HenryLi-0/spark/firmware/README.md

# Firmware

Spark (for now and the foreseeable future) is using [Klipper](https://www.klipper3d.org/)!

NOTE: The current configuration (as of 3/31/2026) is UNTESTED! Be warned!

See [Klipper Config Reference](https://github.com/Klipper3d/klipper/blob/master/docs/Config_Reference.md) for more information.

Configs used:

- https://github.com/Klipper3d/klipper/blob/master/config/generic-bigtreetech-skr-v1.4.cfg
- https://github.com/Klipper3d/klipper/blob/master/config/example-corexy.cfg
