HenryLi-0/spark/CAD/README.md

# CAD

Check out the CAD, made in Onshape, [[here](https://cad.onshape.com/documents/2b9020a6dc26b5be6a34c293/w/4aea5c5de00aac87e58ab18a/e/e89b27766cadd97ed58f8716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)]! Or the huge `.STEP` file under the [over there](</CAD/spark-Full Assembly-2026-03-31 23-42-32.step>)!

*Note: **The 16mm M3 screws in the CAD are supposed to be 14mm M3 screws.** Unfortunately, Onshape's standard content does not include 14mm for some reason. Do NOT buy 16mm screws, there WILL be interferences in some areas. (If you already purchased 16mm, spacers should fix your issue, but no guarantees.)*
