HenryLi-0/spark/updatelogs/logs202607/07132026.md

# 7/13/2026 - 79th Update!

im still around you know lol

anyways, 9:06 PM, the day before flights to outpost! so, yeah, just finished packing, at least, most of it, gonna be quite a night, cant wait to wake up at... err... 3am or something (idk my sleep schedules fried)

ok brb

(did not brb)

anyways im in california now and the hackathon is startin soon (currently 5:38 PM in california), landing and travelling was good!

anyways, since it's like 8PM ish in NYC (i think?), that's it for now, good night!
