HenryLi-0/spark/updatelogs/logs202607/07092026.md

# 7/9/2026 - 76th Update!

yo and welcome back! it's 8:57 PM at night, don't have much time to waste now, today's hopefully printing day? (with the actual printer of course)

saw online last night from like a video from 6 years ago that using blue painters tape is a good idea (why does my s key consistently fall out now aaaaa), well look what i got here (figuratively), it's a roll of scotch blue 2090 tape!

ok, watched a couple of enlightening videos
- https://www.youtube.com/watch?v=meKYCQrZS54
- https://www.youtube.com/watch?v=TZiRAyaxzOE
- https://www.youtube.com/watch?v=gVU5If1VsAM

so, i think we're just gonna use some blue tape, seems pretty much good enough for our purpose, not sure if i really want to get orca slicer just now, i think i just want the printer to at least extrude something at this point in time?

center is roughly (50.00, 77.50, ~) right now, ok, wrote a little something to center the stuff, gonna be in the [`utils/`](</firmware/utils/>) section of the firmware folder, so (0, 0, 0) should hopefully be the center?

yeah, close enough! ok, it's probably a good time to apply the tape

ok, tape applied, cleaned the nozzle, planning on doing the paper thing right after, then we need to print like something flat real quick (if it works, since we still need to do the config stuff for the extruder)

quick 20 minute break to let it cool down later, it's 11:07 PM, time for the paper stuff!

so it doesnt really do a good job at staying level, but i do have a solution in mind, aka, having weights on both the sides to keep it flat. yeah. or my first idea of a rubber band thing stretching the entire length, but that's a bit less realistic. anyways, configs inputted! so at this point, the thing we need to focus on is getting the extruder config up and running!

ok, kinda/kinda not distracted and set up the slicer with the stuff, gear ratio is start (14) to mid (28->14) to final (28->12), where it ends

ok, after a quick sanity check, gonna do a test "print"! it's in quotes since it's actually not gonna have any filament, just gonna make sure the motion works/makes sense

ok, 12:31 AM, let's run it! ok, temperature below min or something (as in the gcode stuff), seems like the networks really spotty today...

12:40 AM and still figuring stuff out, hold on a second... ok, it's running! at least, the stuffs moving, not sure if it's printing well? idk, gonna watch it go! it's going! that looks... fairly realistic? idk why the heatbed's at 60.7C right now

ok, 12:54 AM, filament loaded on the top in a semi precarious matter, things are ready! 12:57 AM, here we go! timelapse running on my phone, let's see it! heat bed termperature good, extruder temperature rising, oh turns out i have to have the tab active for it to update the graph visually, whoops

well, reached the temperature, let's see something? oh it just stopped itself because axis werent homed, ok, test 2! 1:03 AM, z axis is lifting, here we go! hmm so the extruder didnt really try... anything. like it wasnt running the whole time (unless it's just a really small amount that the gearing cant handle?) quick timelapse (lookout) refresh

ok the issue might just be i didnt push the filament in enough, since i just gave it multiple aggresive tugs and a whole bunch just came out of the nozzle, 1:14 AM, here we go again! (i do not want to know what the weird vapors or gasses it just released (yes i saw it, which isnt a very good thing)) also, wow, the heating controls are tuned really nicely! ok, 1:17 AM, z axis going up again

so wasnt extruding anything, had to push on it to move, and that resulted in an obvious pile of sad sad

so i feel like this is a bit of a gearing thing, since small amount arent really wanting to come out

at least it got the rough shape correct? hmm i want to try it out without me pushing on the filament, expecting nothing to happen but who knows

yeah i think its just really under extruding, probably because of slip inside?

1:43 AM, trying again, yep, nothing good, it's now 2:00 AM, gonna go to sleep at this point

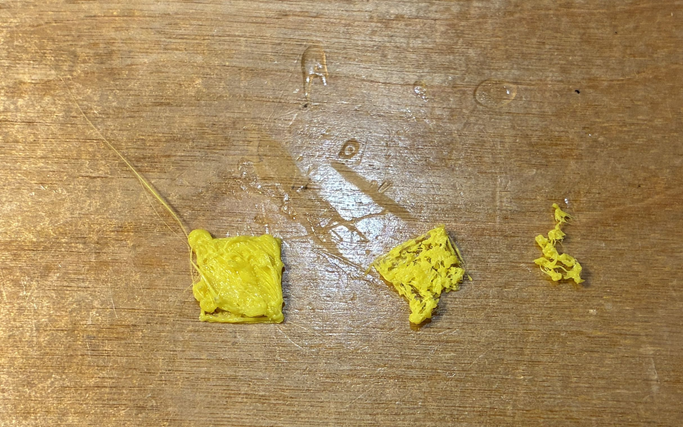
[picture p7: updatelogs/images/202607/07092026 - 1.png]
hmm


yeah. idk. the one on the left is forced filament, the middle had a bit of push at the beginning, the last one was mostly by itself. yeah, idk what to do at this point.

it's 2:03 AM, idk what to do, and yeah, we're kinda behind schedule. anyways, good night!
