HenryLi-0/spark/updatelogs/logs202607/07062026.md

# 7/6/2026 - 73rd Update!

well, today's a late start... anyways, 9:45 PM here in nyc, did some printing earlier but honestly not much, we do have two sets of tool heads to assemble, updated the extrusion gearing to be a bit tighter, idk

sent the smaller side gear to print since it keeps falling off

this thing really doesnt want to get printed

yo why does it keep failing

me when i cut a screw and both halves just evaporate

turns out upping the scaling factor was not a good idea (i increased it before the last few batches), so i guess we gotta turn that back down and suffer through manufacturing again lol

ok, 1:39 AM, being told to go to sleep right now, all other extruders assembled now!

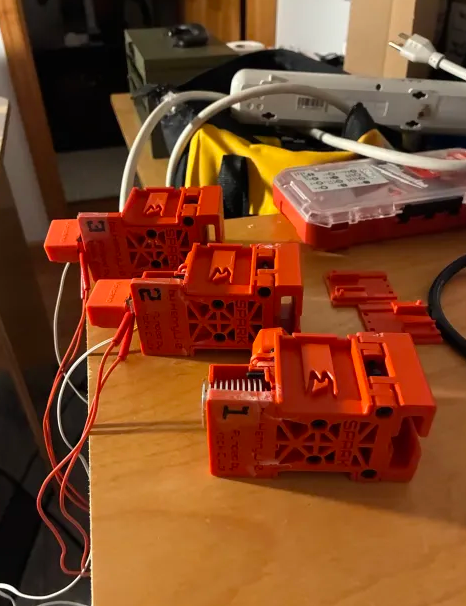
[picture p11: updatelogs/images/202607/07062026 - 1.png]
waw


ok, hopefully tomorrow's a bit more productive, that said, good night!
