HenryLi-0/spark/updatelogs/logs202607/07052026.md

# 7/5/2026 - 72nd Update!

ok, i had like the worst sleep last night, it's 4:06 PM (this sounds a little familiar...), we're back! yes, i somehow couldnt fall asleep after smiling at the printer and stayed up until 6:30-ish AM, then slept till 1PM, idk, my circadian rythmn and sleep schedule are beyond repair

anyways, work on printing today! we want to get printing! ive been considering looking into the bed mesh thing and i think its necessary for what it is because out plate isn't exactly the flatest (yes, i did try to bend it flat on the table best i can)

todo:
- part printing
    - latches
    - additional tools if time permits (not highest priority)
- **DONE** - electornics
    - **DONE** - add the switches or something, idk
- programming
    - **DONE** - set the configs
    - double check configs and all that stuff
    - **DONE** - start testing corexy movement
    - **DONE** - set z axis limits
    - reliability test
    - get extruder gearing to work
    - upload g code and go!

well, yeah, that's the stuff that needs work

can i create a bed mesh with a pulley i just glue to the print head

bathroom, brb

back at 4:40 PM, i should probably lock in 

anyways, how does one even connect this thing oh my S key just bent upwards in a way it never should oh it did it again uh oh

ok so we have to wire up the normally closed side for fail safe purposes (also why the endstops are inverted in the configs it seems)

ok, took like two hours but all that stuff is crimped and soldered, to test inputs time! ok, did the query endstops thing and it all shows up as good, 7:28 PM, off to dinner!

back at 8:49 PM, switches are taped down, didn't timelapse it unfortunately but took like 15 or 30 minutes or something, that's good, idk what to do about the z axis switch, i do want to get stuff printing before i shower though (really shouldve started printing at the start of today)

devestating loading times

well its been a second, stuffs printing now!

huh well i didnt even go shower yet since the rain started turning up and pouring a bit in, but yeah, that's done printing, i guess here comes another tool head?

today i learned you can export everything at once

a ton of bambu studio work later, things sent to print! ok, it's now 11:24 PM and like im feeling really unproductive today, let's get this homing working!

just to be clear, the axis of the printers should match the one in the cad (+x is towards the electronics side, +y is towards the LRS-150-24, +z is up), ok, let's get homing working (minus the z axis), and yeah!

THE DIRECTIONS ARE CORRECT NOW! YES YES YES

ok, the internet kinda went down, but currently working on the config and the min and max and endstop positions!

while the network's a bit down, let's work on the z axis limit! i guess we're just gonna secure it at this point for now? anyways, flipping the printer on it's side, yes it's still ok! we probably should mount the lrs-150-24 a bit better though...

well two parts just fell off the print bed...

ok, back, time to get zeroing the z axis!

the extruder doesnt really seem to want the filament... anyways

(55, 85, 119.5) is roughly the center of the build plate

oh i just realized that +z of the building area is actually -z in real life (since, the higher you go in the print, the lower the build plate needs to be)

ok, that's all fixed now, ok, so we are having a bit of zeroing issues where the corexy rods seem to skip the belt a bit, which isn't really good. ill probably make a print to force it to stay in contact, the belt's already pretty tensioned? ok looks like i have to tension it again but way harder

eh, kinda bored, i guess, oh the print's ready, anyways, as i was saying, 60c print bed test? almost heated the extruder whoops, i guess heating it to 100c is ok? just for a usage test

why the light flickering

ok, looks pretty good, gonna push the extruder to 230C

ok yeah, letting things cool down now, looks good so far!

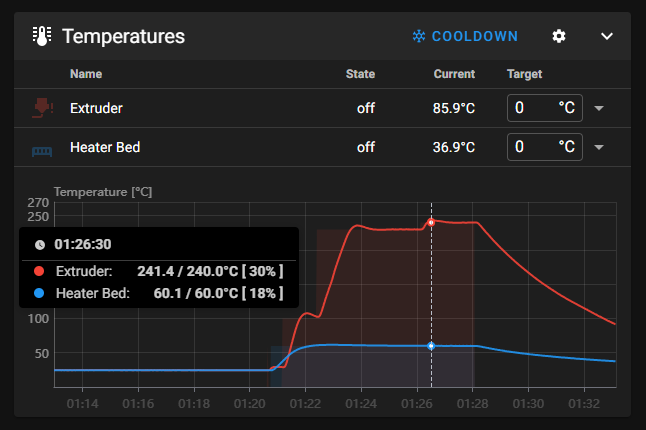
[picture p12: updatelogs/images/202607/07052026 - 1.png]
waw


ok, well, updated the todo list, time to go to bed now i guess

stuff's mostly cooled down by now, it has been like 21 minutes at this point? (from the start of heating things)

it did smell funny when it was really hot. huh.

well, that's it for now! gotta go attend something tomorrow morning and work starts the subsequent days. hopefully can set another tool to print before leaving? idk, well, that's it for tonight, it's 1:42 AM, good night!
