HenryLi-0/spark/updatelogs/logs202607/07042026.md

# 7/4/2026 - 71st Update!

ok, so it's 4:06 PM, a bit late of a starting time, today's theoretically programming day 1! realistically, we have a couple stuff to sort out (printing support plates and organizing the electronics), but yeah, construction is mostly done, i guess printing the other extruder plates and stuff should start soon?

anyways, here we go!

ok, some double sided tape used, gonna now cad a quick mount for the skr 1.4, probably just gonna double side tape it

ok designed and exporting!

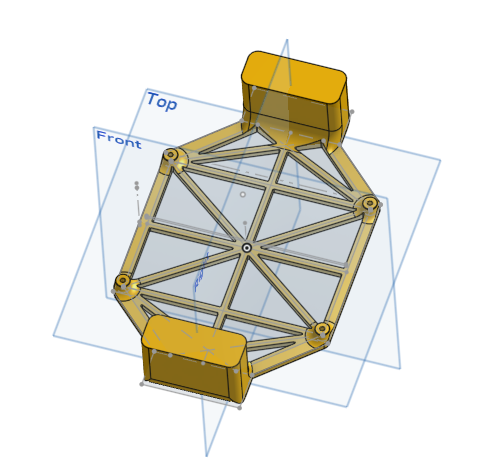
[picture p13: updatelogs/images/202607/07042026 - 1.png]


ok so this ones gonna take quite a bit to print. uh. yeah, idk what to do in that time, oh yeah, we need to screw in the blocks in the corexy for the ones inside the x sliders

hmm programming time, idk why my computer internet seems goofy

| 1 | 2 | 3 | 4 | 5 | 6 |
|A+ |   |B+ |A- |   |B- |
|BLK|   |GRN|BLU|   |RED|
| 1 |   | 2 | 3 |   | 4 |

board pin order is 2B, 2A, 1A, 1B

CURRENT BLK(A+) GRN(B+) BLUE(A-) RED(B-)
CORRECT GRN(B+) RED(B-) BLUE(A-) BLK(A+)

ok, motors moving! yes!

hmm switched the e1 and x a4988 boards

trying to figure out why x doesnt move as much as y

seems to be that port is just meh? or wire?

hmm smells like a config issue

spent like two hours trying to figure out why one motor was faster than the other, now both are slow and idk, i guess im just gonna leave it like that then?

ok, it's 12:23 AM, i dont think we can solder end stops mright now, but things working ok so far!

ok, got the fans wired up, a bit of cable management, it should span the entire area nicely (with some totally advanced zip tie technology), the extruder thermistor is also wired up!

2:16 AM and the heater's wired up! ngl, kinda scared, but hey, gotta test it at some point right?

first test is 30C (85F), ok, seems ok, 35C now (95F), ok, seems pretty nice and warm, gonna say its ok for now!

2:46 AM and idk why it sound like a whole server room or something, theres only like three fans running (including the one in the pi). anyways, wired up the extruder heater, kinda scared to test it (it's either gonna melt, or idk, i dont really wanna touch it). anyways, did a good amount of wire management, we still have to test if the z axis goes all the way up and if the wires are happy with that, and if the extruder wire works (then zeroing and actually printing sometime tomorrow, hopefully the extruder gears are good enough for that)

anyways, no time to waste, rather not write this joke anymore because i really dont want it to happen

wires seem alright, gonna preapre the config for the extruder

extruder ready, let's see it, ok, reached 35C! kinda overshoots but that's alright for now, iirc the heatbed takes a while to reach the target, so upped the p for the heatbed, decreased the p for the extruder, also decreased the z max velocity and max acceleration

ok, looks pretty good! not gonna try going for high temperatures on either one just yet, but we got something to work with now! probably gonna add the end stops, calculate the motion limits, and print a second extruder while that happens tomorrow!

yesterday didn't have a picture, so it's probably good to add one today right (also, we need to print a case for the inlet or something)

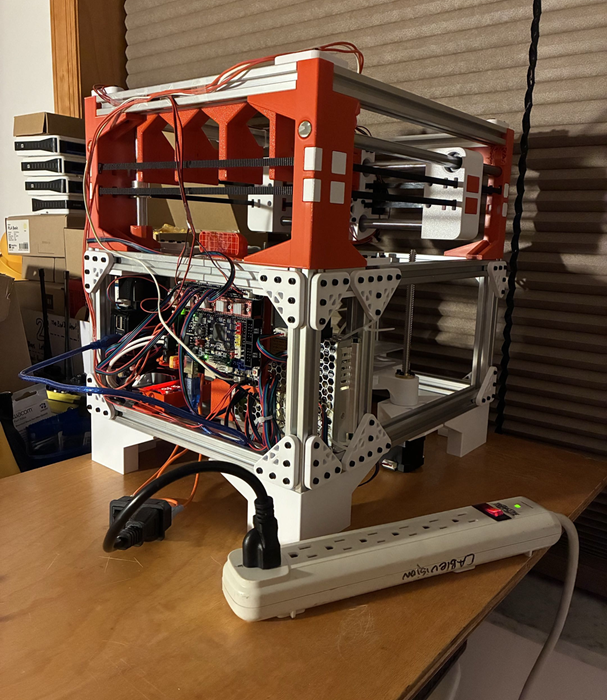
[picture p14: updatelogs/images/202607/07042026 - 2.png]


hmm we should probably update the todo list

todo:
- part printing
    - latches
    - additional tools if time permits (not highest priority)
    - **DONE** - skr 1.4 support plate or something
- electornics
    - **DONE** - live test 3 (inlet, PSU, LM2596, skr 1.4, and raspberry pi 4)
    - **DONE** - connect heating units and other things
        - **DONE** - quite obvious, but fans (x3), heatbed (x1), extruder thermistor (x1), extruder heater (x1)
    - add the switches or something, idk
    - **DONE** - clean up the electronics bay (it's probably cluttered at this point)
- programming
    - set the configs
    - double check configs and all that stuff
    - **DONE** - start testing heating stuff up
    - start testing corexy movement
    - set z axis limits
    - reliability test
    - upload g code and go!

well, good amount done today! mostly actual printing testing and stuff tomorrow!

got distracted for a second and now it's 4:02 AM, here's another picture i was gonna add!

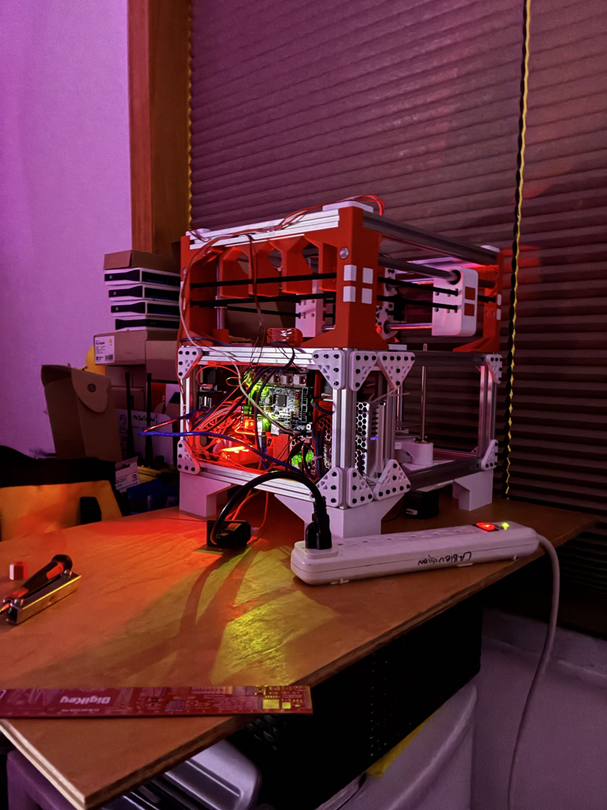
[picture p15: updatelogs/images/202607/07042026 - 3.png]


well, with that said, good night!
