HenryLi-0/spark/updatelogs/logs202607/07012026.md

# 7/1/2026 - 68th Update!

wdym it's a new month... anyways, time to lock back in! electronics work was going pretty decently, time to continue with that, printing gonna be a bit delayed today since the temperature in nyc is abysmal

also need to cut that usb c wire

electronics time, it's 3:37 PM right now, tool stuff getting printed later

half an hour later, cut the aliexpress usb power wire, split the wires, then attached the lm2596 (idk why i remember the numbers) and plugged the usb end (trimmed both sides of the cut) and then saw it worked alright, just a note to check the output voltage when attaching it to the lrs-150-24 (had to check that one) before actually plugging in the pi. anyways, gotta wire the bbt thing with actual power wires, then probably need to do a soldering job for the outlet (well technically isnt it called an inlet? idk)

why are these wires secured with food wrap

for a second i thought i forgot to add the inlet thing to the bom, then remembered its in the digikey bag oops (whys there an microsd to sd card converting case thing in the aliexpress box, whoops, mustve been from last night)

though we have 4m of wire (wait really?), it only wraps around the structure a little less than three times, just an important constraint

ok, so its been a pretty long while. in fact, i learned how to crimp in that time (woah), so that was cool. anyways, check this out!

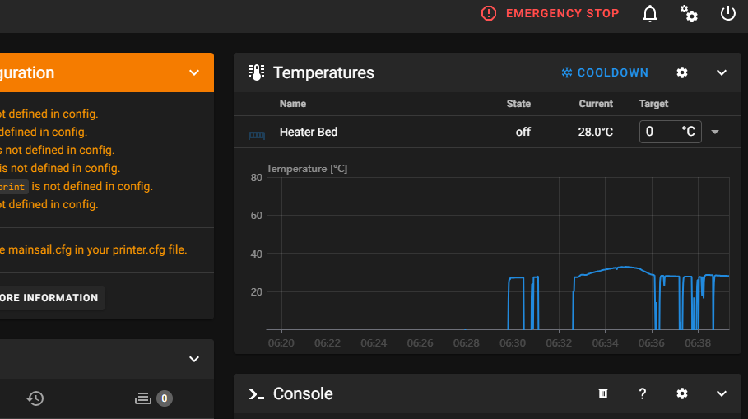
[picture p16: updatelogs/images/202607/07012026 - 1.png]
waw


yep, that's the thermistor on the build plate! it also works with the one on the extruder, so that's nice! anyways, i dont have any free jst connectors on hand, so i cant exactly make it line up, but dupont seems to be working just fine (yes, i know its crazy sketch, shh)! i do probably want to hot glue the connection though... also, ignoring the questionably lower temperatures lol

oh yeah, also did something goofy i forgot, oh right, i struggled connecting the larger 16 AWG wire into the LM2596, turns out the screw was actually a different head and it really looked like another one.

anyways, 7:09 PM, gonna set a tool to print (like, printing tons of tool parts, see ya in a sec)

spam export spam export spam export

ok, set to print, currently 7:20 PM, see ya in a bit, off to dinner, gonna head down to cut the t screws afterwards!

an eventful after-dinner later, the t screws are cut and the corexu has full motion range, and a 15x15 build plate has been created! didnt timelapse it unfortunately since the wifi connection was weirdly weaker than normal, but it was like 45 minutes or something. anyways, the result is an aluminum (?) plate which should be enough for our purposes. the screw holes i drew were a bit off, but it's really whatever, just hopefully it doesnt, you know, go flying off during a print or something.

anyways, the tool stuff is printed! nice! set two is going right now, but gonna test assembly

this is extruder gearing is so cursed. switched everything to use filament instead of, you know, printed rods, everything was just thrown out that couldnt be fixed (only like 7 parts were fine of all that), 

this isnt good, canceled movie night tonight, gonna try fixing all this

i think we're just not gonna use any live axles, just use filament as dead axles, which should let everything spin nicely and remove the need to print out a bunch of bearings/bushings

issues:

- **GOOD** - shaft collar does not have enough clearance
- **DONE** - all gearing axles need to be dead axles for filament now
- filament grabbing gears NEED to be done!
- **GOOD** - no bearings or bushings! please!
- **FINE** - wind tunnel thing just... uh. collapses, but that's fine for now
- design does not consider wiring! like, at all!

one crimping intermission later, i think we just need to stick a bunch of toothpicks to edge the dupont connector to work with the jst. yes, that's probably a sentence you never expected to hear, i know. anyways, electronics aside, WE HAVE CAD TO FIX! my idea is getting started earlier tomorrow, setting all the tool stuff to print, then working on the corexy belting and the rest of electronics while waiting (a solid two hours of printing should provide enough time?)

yeah so its been a while and got a bit side tracked

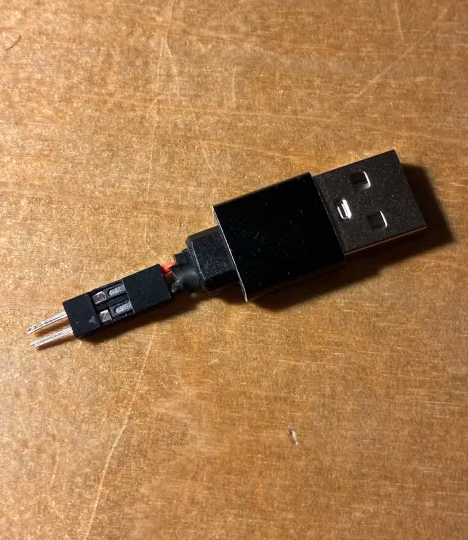
[picture p17: updatelogs/images/202607/07012026 - 2.png]
hmm


anyways, 1:57 AM now, gonna end it here, lots to clean up yikes, hopefully earlier start time tomorrow? anyways, that's it for now, good night!
