HenryLi-0/spark/updatelogs/logs202606/06302026.md

# 6/30/2026 - 67th Update!

funny number haha

anyways, actually started at like 8AM today, but starting to write logs at 3:46 PM right now, did quite a bit of work, finished printing the pulley areas of the corexy stuff, i guess its time for corexy assembly!

ok, 4:10 PM, let's actually start

so its 6:55 PM and we got a corexy layer now! there is a bit of wobble, but i hope the belts and stuff should be able to sovle that, some docking bay stuff is printing right now, the t screws are still too tall so we'll have to cut them a bit later, had to cut the corners of the upper sliding sides of the pulley areas since they had collisions (shouldve checked for this), but they've been removed (not spending 8+ hours printing new ones and using like 230g of filament), so yeah, got a bit of clean up to do over there

gonna reflash the sd card with raspberry pi os to see if that works, ok, flashed, testing!

ok, so it works. huh, but not with mainsail?

funny info i cant seem to ssh in, but it does work over ethernet! anyways, the docking bay parts are printed (nice!)

ok, been a bit, set the printer to do 24 bearing flanges, hopefully doesnt go wrong? anyways, gonna go watch a movie now!

back at 12:51 AM, assembling bearing stacks!

after a quick timelapse, bearing blocks assembled and added, and the docking bay exists! they're kinda off centered right now (+/-0.5cm each???) as in, with different sizes, not sure how to fix that, probably will just realigned it once the tools and stuff come out (speaking of which, we need to get those printing)

also, mainsail started working before! just set the wifi info in the microsd (using the changing wifi guide thing on the documentation) and now it appears!

ok, so the reason why it wasnt powering on was that i didnt switch the jumper thing from input to usb power, oops, so idk why i still cant ssh in, imma just reflash again and just not play around with the host name since that doesn't seem to work anyways

assembled two slider bearing stacks and now back to working on the pi!

ok we in! seems like it just didnt accept any of the custom config stuff. huh. 

WOO! IT WORKS!

ok, it's like 4:02 AM, just finished cleaning up, this thing is kinda huge... anyways, yeah, tools and electronics tomorrow i guess!

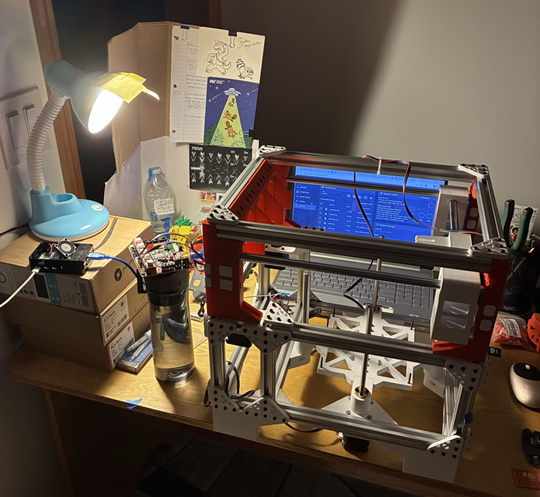
[picture p18: updatelogs/images/202606/06302026 - 1.png]
waw


so yeah! pretty cool, yes, i know i shouldnt expect the motors to run off a single usb c connection powering a raspberry pi 4 powering the skr 1.4, so we kinda need more power (or maybe we just have a bad connector, idk). anyways, we still have to cut the t rods, and still need to figure out the shaft collar situation, and probably belt the stuff tomorrow.

anyways, with that, decently productive day today, 7 days over, 5 days left, it's 4:05 AM, good night!
