HenryLi-0/spark/updatelogs/logs202606/06292026.md

# 6/29/2026 - 66th Update!

woo! 2:46 PM, nyc is currently really hot (what do you mean heat watch?), so i gotta close the printing room door and blast myself with a fan (the printing room has the windows open)

so turns out i actually have to go outside to get glasses or something, imma just set the lift plate thing to print since that'll take forever, then we have to discuss schedule stuff

erm thats a lot of filament (56.39g)

ok, 2:54 PM, sent to the printer! gonna go now, brb!

4:51 PM and back, actually came back earlier (the store guy wasnt there) and got tired and laid down for a bit. anyways, part printed! gonna print the top part now and then write some stuff

once we get to like 800g used i think im gonna swap out the spool

top plate is 43.75g, wow, thats a lot of filament (100g+ used today already?)

- **DONE** - S 6/27/2026: continue printing (tools), extruder and heat bed assembly
    - expected doctor visit
-  **NOPE** - S 6/28/2026: continue printing (big), electronics assembly and check

so, seven days (including today) left in schedule, let's take a look into how it should play out!

- M 6/29/2026:
    - continue printing (z axis, corexy)
    - z and corexy assembly
    - electronics assembly (day 1)
    - STRUCTURE (minus electronics) SHOULD BE DONE EOD!
- T 6/30/2026: (expected doctor visit)
    - docking bay printing
    - find a print bed thing
    - tool parts printing (day 1)
    - tool assembly (day 1)
    - electronics assembly (day 2)
- W 7/ 1/2026:
    - docking bay assembly
    - tool parts printing (day 2)
    - tool assembly (day 2)
    - DOCKING BAY AND TOOLS SHOULD BE DONE EOD!
- H 7/ 2/2026:
    - final checking (prints, etc.)
    - secure electornics connections
    - electronics check and live testing!
    - FULL STRUCTURE SHOULD BE DONE AND READY TO PROGRAM EOD!
- F 7/ 3/2026:
    - flash firmwares
    - write config files
    - start testing actual printing
- S 7/ 4/2026:
    - start testing macros and multi tool printing
    - additional tuning
    - do any jank fixes needed
    - STRUCTURE SHOULD BE FUNCTIONAL EOD!
        - single tool is fine if need be
- S 7/ 5/2026: ship day
    - reveal video filming and editing!
    - read requirements and submit for review!

ok, seems pretty through, i guess we should start preapring the bearing stands for printing! after thinking about it, it's probably not structurally worth it to split the parts (idk, glue it back if it breaks), it's probably more worth it at this point to just increase the strength (by increasing the support angle) and just print it as is (it's gonna use a LOT of filament)

ok, electronics assembly time i guess (wait no cad time first)

some things we need to fix:
- **EHHH** - the tall pulley area thingies (the z direction prints at the corners of the coreXY area) could probably be split into multple pieces for better assembly and repair
  - they also take a scary amount of filament to make lol
- the corexy motor rod shaft thing doesnt have a top bearing area for extra support

and the old news of things to fix:
- the additional extruder mounts collide with the belt (just put it at a sideways point thing)
- the magnets are not cadded
- **SUPPLY** - we do not have anderson powerpole connectors or anything (find some contact solution? i dont really know how to solve this one)
- **SUPPLY** - there is no heatbed irl (just a buying and manufacturing issue for now)

the aforementioned todo but not urgent list
- add blocks for easier belt pathing in redirect blocks in x rod sliders
- **GOOD** - fix -x bearing redirect blocks being a bit too short because of clearances (probably just switching the direction)

well thats laggy

ok, a while later, got the z axis lift base thing added, it does wobble a bit, but the line that's formed between the two t rods is pretty strong (that line's also the axis of the wobble). anyways, did a bit of wire management so that they're no longer in the way, also decided to use a drill to tighten a couple since some weird thing happened before

huh shouldve sent the stands to print during this time. anyways, a really long while later, all the cad stuff fixed

9:41 PM and back, just printing stuff right now, got all the electornics stuff unboxed, excited to look into that! anyways, yeah, the redirect blocks have been printed (but i forgot to print the axles aaa), so that's good

anyways, skr board prep and install time! also, switched the filament to red and now printing the pulley area! (hopefully this is good tolerance? idk, switched it to 0.0075cm)

ok, spreadsheets updated (shouldve timelapsed it but its whatever), gonna do the electronics stuff now!

ok, so it should be added correctly according to the video, i just need some firmware on this

currently watching [this](https://www.youtube.com/watch?v=gfpovViNu0U) video on installing klipper!

i am learning much right now

erm

shouldve started timelapsing a while ago, but sure

quick detour to printing (it came out really well!), ok back

wiring notes:

- refer to configs for the motor stuff
- fan switched from FAN 1 (left) to FAN 0 (right)
- z motor 2 moved from E0M to ZMB
- extruder motor moved from E1M to E0M

was working on wiring while stuff was flashing, and stuff seems flashed now! gonna see what to do next in the tutorial... gonna plug in the raspberry pi into the wall

so idk whats its doing right now, light is stable, no longer blinking

is this sd card faulty or something why does it keep crashing aaa

actually i might use a raspberry pi 3 model b v1.2 for this instead (ignore the fact its from 2015) since it has headers and i dont really feel like soldering headers (or i can use the other raspberry pi zero 2w with headers but eh)

mfw the sd card says nope twice (it keeps failing on verifying half way)

did i break and sd card? idk erased contents and reset to be a fat32 drive, trying again

nope failed again

trying a different card, this one seems ok for writing, idk (put this one inside the skr 1.4)

i guess its a really good time to work on cad

ok, write finished, time to test it out! so the power led doesnt switch. shouldve tested that. huh.

eyy the 4b one works! probably shouldve used that first, oh well

ok, 1:48 AM and back! as in, back to writing this! so, raspberry pi thing is still being weird, idk what to really do about it, but (hold on one second, need to fix some collisions) the docking bay is updated!

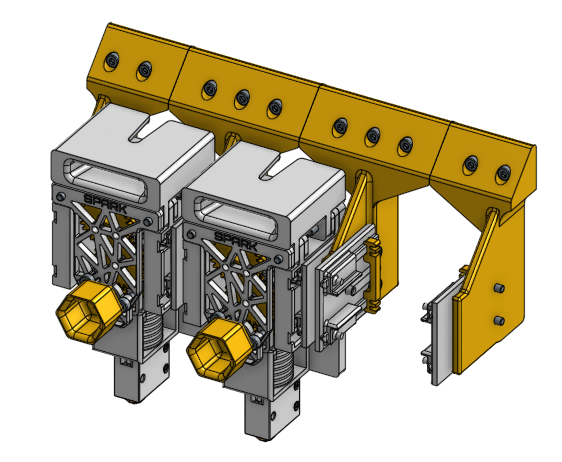
[picture p19: updatelogs/images/202606/06292026 - 1.png]
hmm


not the most aesthetically pleasing, but id say it's good enough!

well, gonna try some stuff with the pi, today wasn't really too much action, but yeah, see ya tomorrow (gotta go to the doctor aaaaa), it's 1:56 AM, good night!
