HenryLi-0/spark/updatelogs/logs202606/06282026.md

# 6/28/2026 - 65th Update!

well, it's kinda late today to start, it's currently 2:36 PM, i actually was forced to get up early today, but i was kinda tired and fell back asleep and didnt feel like doing anything

then i realize theres 8 days left, and now im back! so, day 5, here's the thing. we got cad work to do, hopefully bearing stands printing tomorrow (since i gotta go to the doctors again, dont worry, its just yearly check up stuff, nothing huge), hopefully corexy assembly tomorrow

now, i want to test something, which is if the amount of length we have for the extrusions enough, as in, if i were to put the corexy rod (the y direction one to the sliders) would it bend (as in, it should be able to keep it straight)

1.9cm with the x slider seems really strong! still got the issue of bearings being too slippery, but thats kinda whatever?

it would be smart to print out the motor mounts real quick, that way we can get started of mounting the motors and figuring out wiring!

yeah, i think it should be fine if we dont print the top, i dont think it collapsing rotationally would be a problem! anyways, we got an extrusion to remove from existence...

tmm extruion no longer exists!

top z axis stands stuff also no longer exists! should be pretty straightforward to reverse? (no version oops)

idk why the full assembly's z axis isnt updating, gonna just place it again

oh yeah, when cutting the stuff, i told my dad to cut the 14.25cm motor rods to be 15cm instead, since we just had the extra space! gonna update that real quick... ok, gonna check that the z axis is valid now so we can hopefully start making that soon? also, we really need to write an update log to the site

z axis has 13cm of range, plate and nozzle are 12.03cm apart! that's good!

might be a good time to send it to the printer! as in, the corexy motor mounts and the z axis! quick printer setup and moving... ok, just realized the alignment is off, one second... ok, now trying to save a bit of filament, currently 39.23g, removed the corners and its 36.75g now

ok, so while thats running, im gonna journal the stuff real quick, then continue cad work!

back at 4:17 PM, that was a bit of journal writing, kinda didnt have much to say for the frame construction work and yesterday's extruder assembly, idk

anyways, z axis is going to the printer next, so i should probably prepare for that soon, but yeah, corexy, do i have anything really big to fix (i do want to make the strengthen the stands somehow? idk, can't change the heights now)

gonna copy paste the list once again

some things we need to fix:
- the tall pulley area thingies (the z direction prints at the corners of the coreXY area) could probably be split into multple pieces for better assembly and repair
  - they also take a scary amount of filament to make lol
- the corexy motor rod shaft thing doesnt have a top bearing area for extra support

and the old news of things to fix:
- **DONE** - the z axis doesnt reach the extruder (just increase the bottom thing's height, just some jank cad solution is ok)
- the additional extruder mounts collide with the belt (just put it at a sideways point thing)
- the magnets are not cadded
- **SUPPLY** - we do not have anderson powerpole connectors or anything (find some contact solution? i dont really know how to solve this one)
- **SUPPLY** - there is no heatbed irl (just a buying and manufacturing issue for now)

the aforementioned todo but not urgent list
- add blocks for easier belt pathing in redirect blocks in x rod sliders
- fix -x bearing redirect blocks being a bit too short because of clearances (probably just switching the direction)

4:48 PM, prints came out just a while ago, i guess its motor mount assembly time?

36 minutes later, with some awkward screwing (since, the screwdriver and the screw together doesnt really fit) (wait, now looking at it, the screwdriver is like almost exactly the height between the extrusions), the motor mounts are added! shouldve done cad review and sending the z axis to print while that was happening, but whatever i guess

disappeared at like 5:30 PM, back at 6:46 PM! just did 0-39 on nine paws, so thats cool! also preparing to write an announcement about hack club and stuff for something. anyways, preparing for z axis parts in the spreadsheet!

quick visit at 8:12 PM, working on fixing the z axis assembly real quick, doesnt seem to be a big issue! ok, a bit more inspection later, seems good, continuing to print! (motor mounts were finished during dinner time! looking to be able to assemble the z axis base stuff tonight) also, next doctor visit will be on tuesday (the day after tomorrow), not monday (tomorrow)

9:48 PM, havent been locked in at all, ok, an hour later, it's 10:55 PM, z motor mounts installed and hopefully aligned! unfortunately, i was gonna print the z lift arms, but the amount of supports needed is actually atrocious (8g of support for 66g of total or something like that)

ok, just undid all that, uh, idk what to do here

you know what, i might just print it with the supports, it might be worth it for the extra bit of better assembly and support

ok, 11:27 PM, sent to print! ok, while that's going, let's add the other z axis stuff, to the timelapse!

wait am i geniuinely aaaaa

ok, so its been an hour and the z rods are added, cool! but i was thinking about it and i dont think we have anything coupling the corexy motors to the rods. aka, the rods dont exactly have a way to move with the motor, at least for the corexy ones. right? did i forget that i added it or did i actually forget this. well, idk, the show must go on

anyways, i was gonna write that here comes the exciting part where we take out the motors (again!)! they're still sitting in the box right now, waiting to be opened! (if they're the wrong size, im telling you...) also, the arms came out!

so, its been like two hours or something, idk, it's 2:34 AM. ended the timelapse a bit ago, probably like 15 minutes ago, and just taking a step back to look at all this. it's insane how much work has gone into this and how it's falling (not perfectly though) together (bit still, it's beautiful!).

anyways, that started after i was looking into whether i can speed get a shaft collar on aliexpress (all delivery times are like likely after a week), then into if i can get the robotics cnc (summer stuff starts like a week from now), then i just thought of somehow forging my own or something (idk, just give me a giant block of metal somewhere lol)

idk, probably gonna design and 3d print some sketchy shaft collar (but make all the measurements smaller so that we have to make all the threads and stuff)

oh right, what happened in the timelapse? well, let's just say the motors were added, and the starts of the z axis!

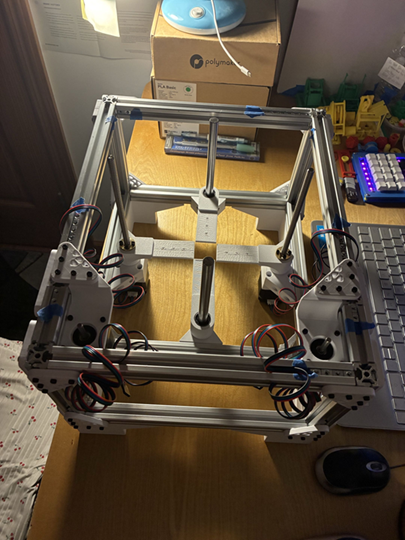
[picture p20: updatelogs/images/202606/06282026 - 1.png]
waw


only one image today? yeah, kinda locked in at the end, moving photos over constantly from my phone to the laptop and to the update log is a bit annoying (that's why theres a bit of photo spam at the end of the logs these days), well, we didn't assemble all the electronics today as planned by the schedule (i forgor that's the goal today), yesterday was "do this two more times and times up" day, so we now have one week left, which isn't too much time, given that we've spent five days so far. idk, if i can get a frame in two ish days, we should try to keep that momentum going?

ok, 3:09 AM now, good night!
