HenryLi-0/spark/updatelogs/logs202606/06272026.md

# 6/27/2026 - 64th Update!

im back! so it's 5:12 PM, got back from the doctor's office, 9 days left now! so right before i went outside, i set the printer to print a slider block, and it came out really really really well! gonna set the second half to print and then gonna shower real quick

rods take a bit of effort to put in, but thats alright

also, forgot to mention, used 203 t nuts and 128 screws yesterday! 

while that prints, gonna have to screw in the stands!

wait its probably smarter to add the bmm extrusion first actually

ok, added the stands to the frame, had to take out the bmm extrusion after putting it in to correct some t nuts (forgot to add some),  so thats good, also ahd to add t nuts to the extrusion for the motor mounts, so that took a second

im thinking of turning the motor mount to have a little 2x2cm area so it still gets that extra support the gusset brings without needed an extrusion

ok, things printing, kinda stopped doing stuff at 6:38 PM (as in, timelapse and assembly worked ended there, then just watched the printing). it's currently 6:56 PM, off to dinner!

back at 7:43 PM! gonna have to shower soon, but gonna remove the supports and stuff for the slider real quick... ok, a quick timelapse and 10 minutes later, got the supports and stuff removed and it looks good! the support kinda messed up on one side, but it seems fine, just took a bit of cleaning up

anyways, 30 total hours so far! woo! we're currently averaging like 3 hours per day, which is kinda abysmal, but it's going up! ok, 7:57 PM, gonna head off to shower now, i could probably set something to print? i guess part cooling fan, though im kinda nervous if it messes up, since, well, its a really thin structure... idk, we need to get the cad work going though

erm that air flow is NOT gonna be cooling that part, idk, i guess imma just shower now, its now 8:09 PM lol

yeah, kinda finished showering and stuff at 9:15 PM or something, but its now like 10:00 PM and im just tired today, three days of waking up and only working on this is kinda tiring lol (but hey, its lots of fun though!)

unfortunately, can't really take a break, but let's just plan the rest of the stuff

- **DONE** - F 6/19/2026: plan and small cad fixes
- **DONE** - S 6/20/2026: cad fixes and prepare procedure
- **DONE** - S 6/21/2026: cad fixes and prepare procedure
- **DONE** - M 6/22/2026: print spreadsheet work
    - exam review day
- **DONE** - T 6/23/2026: start printing
    - exam day
- **DONE** - W 6/24/2026: continue printing (gussets), prepare extrusions and rods for cutting
- **DONE** - H 6/25/2026: continue printing (big), extrusion and rod cutting
- **DONE** - F 6/26/2026: continue printing (tool base), assemble base frame

ok, so we're pretty much on good schedule for the past, but today, not so much, let's just do what today was supposed to be, aka extruder assembly, i think we can print the tools tomorrow after some cad finalizing today (or maybe print one right now???)

timelapse starting, assembling the v6 extruders! shout out to me on 11/12/2025 for the video!

ok, 10:49 PM and three extruders done! assembled in half an hour, not sure if they're all the same heights and stuff (the guide wasnt exactly specific about how to assemble that, i guess im gonna go through them and realign them if needed, would be better to zero, actually, we can't do that, never mind)

anyways yeah, 10:50 PM, gonna go watch a movie, so the extruders and heat beds were assembled! (the heat bed doesnt really need assembly ngl)

ok, it's 12:37 AM, surprise tool base assembly, gotta be quick though!

huh, idk why windows just froze

ok, it's 1:10 AM, and that's also done! turns out the fan mount on the right side (when facing the side that says tool base) is kinda badly printed (and also need to clean out the support mess below it), but it's fine... i think. anyways, the fans didnt come with threads, which was a bit annoying, so i instead just used the screws thinking it would at least force it to not move, but turns out it kinda just worked out. idk how, but they're mounted now, probabaly because the screws were slightly misaligned and that forced the fan to mount. idk.

a little bit of cleaning up the area later, here's the pictures! (before cleaning up)

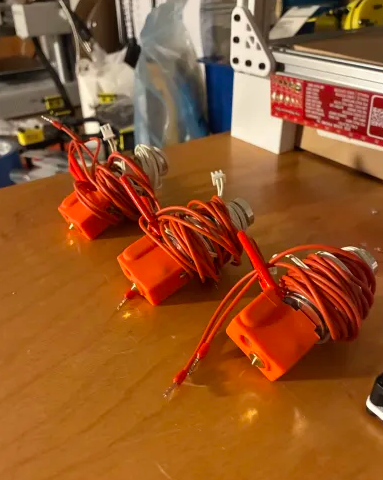
[picture p21: updatelogs/images/202606/06272026 - 1.png]


three extruders, all set up!

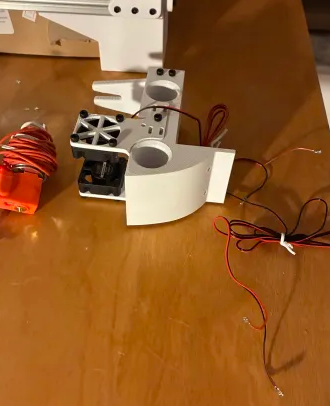
[picture p22: updatelogs/images/202606/06272026 - 2.png]


the start of the tool base! (ignore the fact that the fan mount is not flush, it's just the clean up of the support stuff as mentioned previously)

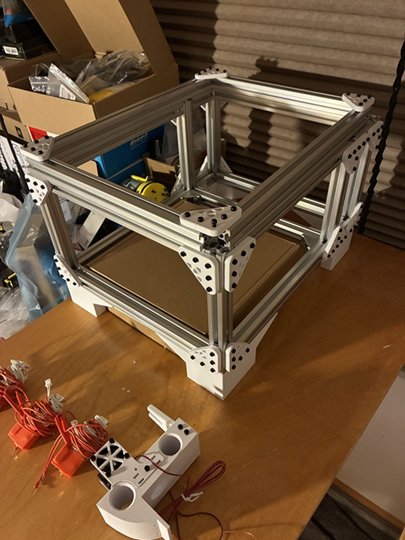
[picture p23: updatelogs/images/202606/06272026 - 3.png]


and of course, the frame!

ok, it's 1:30 AM, hopefully gonna be able to do much more tomorrow and prepare the stands and stuff, idk, we also got cad work to do. well, that's it for now, good night!
