HenryLi-0/spark/updatelogs/logs202606/06262026.md

# 6/26/2026 - 63rd Update!

if today was the 62nd update that would be such a fun coincident (62 on 6/26/2026)

today starts at 3:31 PM! yes, i woke up way earlier than that, but did other stuff instead. now, lemme move my laptop to the other table real quick, today's frame assembly day! gonna try assembling as much as i can to specs, then gonna cad i guess (are we printing? i guess we can do some printing)

ok, printer is setup, what's this, outpost announcements... anyways, gonna think about that a couple days from now since this is kinda my biggest priority!

printer is trolling or something, took a sec to load i guess, tool base printing day! (and maybe also slider printing day?) ok, currently writing the spreadsheet

tring to fix these tree structures

ok, 4:00 PM and its sent!

ok its 4:05 PM and its starting! gonna do a timelapse while its printing!

i wonder if the timelapse adds to hackatime counts? currently says 1hr 6m today, 142hr 30m 47s on hackatime total (for this project), anyways, to assembly!

i think i mightve found the first gusset wow

eyy 5:53 PM and the prints done! still screwing in stuff though!

6:18 PM, gonna get some water and take a break for my wrists lol (well, im typing so not really), but hey, one frame side done, second starting! some 2hrs+ of screwing things in! for hackatime, it now says 3hrs 19m today, 144hr 44m 26s on hackatime total (for this project), so yeah, i guess it does!

back at 6:23 PM, now, for the stuff about the tool base print, seems pretty alright, thought the bearings fit way too easily (probably gotta put some glue or something to keep them in, idk), the text came off really well, the whole assembly (as in, just a linear rod, a bearing, and the tool base) worked together really nicely! the whole thing slid together quite well. however, the belt really doesnt want to look very much, but the solution is really just to cut the part so that it looks over the cooling fan mount which, by the way, screws in pretty nicely (as in, the screw hole, the mounts arent printed yet). i should probably have checked if the motor fit first. oh well.

anyways, next up, printing the mounts! also, yes, i released all the belt length out of the bag and the whole thing does not want to coil back up, so the bags just, yeah kinda stuffed with belt material. anyways, to printing!

how did i send a print job to a printer that isnt powered on?

ok it's sent, 6:48 PM, back to frame assembly!

some time later- aaaaa

anyways, after the tool base just fell on my foot off the table (ow), both frame half thingies are done! it's currently 7:29 PM, im 25 minutes late to dinner, but when we're back we're gonna start connecting the two halves!

back at 8:35 PM for a quick second, gonna set the tool base connection printing while i shower, then when im done we're gonna continue assembly!

ok, 8:41 PM, see ya in a sec!

ok, 9:50 PM and back to business! tool base connector printed nicely, came out really well actually1

back to frame work! (haha get it framework? anyways...)

12:07 AM, done with that! wow, like, what, 5? idk, hours of screwing in and stuff, and the frames done! well, almost. the little extrusion on the bottom isnt done yet, idk if we're watching a movie right now? ok, i guess we are

ok, back at 2:24 AM, so we still need to fix some stuff (alignment i guess) and add the stands, and do the pulley area printing stuff, so yeah, quite some work to do, i am a bit annoyed with the fact that some stuff are just barely a bit off (like, the 26cm extrusions are +/-0.1cm), but im happy they're cut and all, it was more of a mistake on my end of not realizing i had to account for the blade width. well, yeah! just gotta line some stuff up, this thing is suprisingly really really really big, like i think the base is big and then im like "oh the heights kinda short", then i remember its supposed to be twice the height for the corexy layer and also needs the stands added. idk where to put this, really. well, problem for another day lol

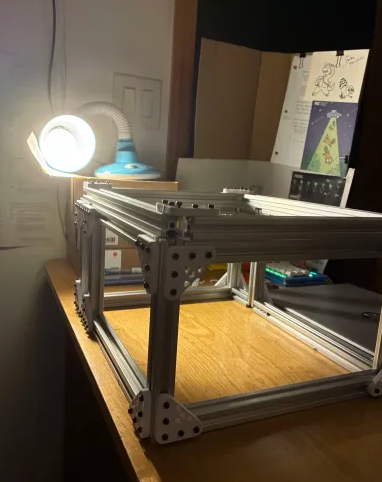
[picture p24: updatelogs/images/202606/06262026 - 1.png]


so yeah, cinematic photo number one!

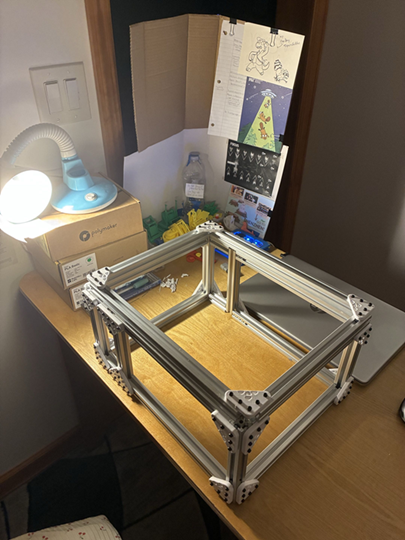
[picture p25: updatelogs/images/202606/06262026 - 2.png]


and cinematic photo number two!

so yeah, gotta stay on track, gotta try to finish the cad updates and start tool assembly and the corexy very soon, gotta go to the doctor tomorrow afternoon, so hopefully we can run some big prints (hopefully the pulley areas? though, multiple at once seems pretty risky...)?

well, 2:34 AM, pretty busy day today, pretty busier day tomorrow! ok, good night!
