HenryLi-0/spark/updatelogs/logs202606/06252026.md

# 6/25/2026 - 62nd Update!

so, checking slack this morning gave me a real reality check of sorts. we had 14 days left yesterday (or two days ago? idk), so we have like 11 days left, according to the little board i have set up now. that's not a lot. but at the same time, it's plenty to get going, if i can lock in lol

anyways, 3:55 PM here in NYC, kinda a breezy day, today's gonna be more printing and, wait, what's that? yes, cutting day! hopefully! gotta prep the extrusions (they're kinda covered in little aluminum chips, the kind you cant really eat, so that's gotta get cleaned up)

schedule today wants to do some cad first so we can start printing bigger blocks, remember, we're fighting time right now! the idea is that we can print some big prints while we're cutting (gotta wait for my dad to come home for help with that, idk what tools i have that could possibly cut through that (no, not scissors.))

cad checklist, come again?

some things we need to fix:
- the tall pulley area thingies (the z direction prints at the corners of the coreXY area) could probably be split into multple pieces for better assembly and repair
  - they also take a scary amount of filament to make lol
- the corexy motor rod shaft thing doesnt have a top bearing area for extra support

and the old news of things to fix:
- the z axis doesnt reach the extruder (just increase the bottom thing's height, just some jank cad solution is ok)
- the additional extruder mounts collide with the belt (just put it at a sideways point thing)
- the magnets are not cadded
- **SUPPLY** - we do not have anderson powerpole connectors or anything (find some contact solution? i dont really know how to solve this one)
- **SUPPLY** - there is no heatbed irl (just a buying and manufacturing issue for now)

the aforementioned todo but not urgent list
- add blocks for easier belt pathing in redirect blocks in x rod sliders
- fix -x bearing redirect blocks being a bit too short because of clearances (probably just switching the direction)

ok, i think we can start printing the big blocks at the bottom of the printer, those aint changing anytime soon, after that, probably tackling the docking bay and the z axis is good? i do want to make a tool soon though, idk

ok, exporting, time to see how scary the numbers are, 55.90g with default, not horrible, switching to 10% gyroid, 48.79g, not bad, 5% infill (WHATTT) gyroid is 40.81g, eh lets go with 10%

a bit more spreadsheet work later, we're expected to use like 195.16g of filament today, which is insane (like 50% more than yesterday), bring total filament usage to 414.14g, which is, again, insane (that's half a spool)

i mightve underestimated the amount of filament this project needs

i mean, i suppose i can make the supports smaller, since they don't exact need to be that big? (they are currently 6cm x 7.5cm)

instead of suspending every 1.25cm in the air, we can turn that to 0.25cm or maybe less? ok, the entire cad is solving itself again it seems, ok, looks good! also, not gonna change the support sizes since i just realized they look fairly small/ok in real life, so im not gonna touch that

ok, 43.42g now, saved like 5g, brings our expected usage today from 195.16g to 173.68g, not a huge reduction, but ill take it!

any more ways to optimize... 7.5% infill? might be pushing it, ok, we're doing 7.5% infill!

expected usage today from 195.16g to 160.84g, saving 30g is pretty ok (saving 13g from 10% infill)

4:30 PM, sending to printer soon...

just cleaned the tool cleaning area and i dont want to know how many microparticles got into me

why does reorienting the print change the filament usage? eh i guess that makes sense

4:35 PM and sent off! gonna use the bathroom now, brb!

4:46 PM and the first couple layers seem good! wait i didnt fillet it did i... oh. well, i guess its fine, just gonna be a tad bit annoying to... oh whys the thickness 0.3cm. yeah i didnt check this enough did i.

basically, we're gonna need spacers or something since it needs that distance so that it doesnt, well, drill into the extrusion

welp, problem for future me i guess, unless we want to do a sunk cost fallacy thing here

surprise! seems like 0.4cm was enough? idk, grabbed a caliper and eyeballed it, idk, should be fine with the nut

ok, back to cad

can go up 11cm, distance is 12.030cm, need an extra 1-1.5cm of height

we either modify the big lift at the bottom (i dont really want to mess with this) or change the top holders (i also dont want to mess with this)

considering if the top stuff is really necessary, since the lift itself acts like a constraint itself?

so i kinda got tired at 5:00 PM and just didnt do much, so the second (-x +y) stand is being printed, it's 6:08 PM now and my dad is home, so im gonna switch to double checking the measures and getting the stuff cut

iguhfsaguoashdgokajsdklfjasldkfjaklsdjafksdjg
asdg
sdfasd
gA 
sd
gasdgasnfgaklsdnglkjaKLAJFLKAJDGLKASJDLGASJDGKLDASJKLFJDS

so im a moron

i miscoutned the number of middle frame y

it should be 3

not 2

we didnt have enough length anyways

nothing i can do at this point

i mean you can shorten the print area by 6cm to get that

nope not happening

ok it cant solve the linear rods

- 40CM ROD - 38 (38 TOTAL) (2 left over)
- 40CM ROD - 38 (38 TOTAL) (2 left over)
- 60CM ROD - 25.6, 14.25, 18 (57.85 TOTAL) (2.15 left over)
- 60CM ROD - 25.6, 14.25, 18 (57.85 TOTAL) (2.15 left over)

ok, double checked, looks ok

ok, i have returned at 7:41 PM, after a session of cutting the extrusions and rods with my dad! i should probably wash my hands, one second...

ok, im back! so, we cut all the stuff, some notes to remember:

- cutting takes length! turns out, having 0cm left to spare is a bad idea since were using like the blade saw up down thing (idk what its called, a cold saw but its not cold and goes to higher rpms). this means, some extrusions are a little under, but the larger gussets should take care of that
- theres real sparks! using the smaller tool (like a screwdriver but instead of a tip its a giant saw/sandpaper pad thing) for the rods threw a lot of sparks everywhere! idk, got scared and ran a bit away
- cutting those rods stinks! literally! it smelled like something burning (this cant possibly be good for our lungs)
- im an a pretty bad person at times. this is a bit more of a me thing, but i should be more grateful for being able to have access to so many resources and a really really cool dad who has a weirdly large amount of tools in the garage. i should stop being a horrible person sometimes and really treasure these moments. i am the problem sometimes and i do know i make mistakes, but i should try to take accountability sometimes for my actions and feelings. (yes, i know i usually take account of my shortcomings, but im saying that i should do it for all my mistakes)

sentimental bits aside for a second (we're like really late to dinner), the third stand printed perfectly! well, it did run at normal speed instead of ludicrous, but sure. gonna put in the fourth and final stand, and thats our basic frame (shh dont talk about the coreXY layer pulley areas) mostly done!

ok, 7:53 PM, final stand sent off to the printer, idk why some parade is going on outside or something, im gonna go to dinner now! (now, to move that giant bag of extrusions and rods in the living room... (the bags gonna instantly rip, isn't it...))

back at 10:34 PM! well, we can pretty much assemble the lower frame now! idk should i? i can wait till tomorrow (or can i lol), ok, im not actually back, one second...

back at 11:33 PM! just laying everything out right now!

AAAAA THE BMM EXTRUSION DOES NOT AHVE ANY SUPPORT

so, after a timelapse, it's 12:22 AM! basically, it works! as in, the gussets do. i had a huge fear for a second that it wasn't, but the screws just barely go in! it's arguably a bit sus, but it should be alright when the whole thing is assembled (except for the part where some things are a centimeter too short, idk how to sort that one out)

and the thing with the bmm extrusion? well, the 4x1220mm extrusions, which were already super cheap, actually came with some bonus corner triangle bracket thingies, so that's actually gonna work! idk how that came together so nicely, but huge thanks for that extra bonus thing that i didnt think much of thats actually helpful now!

anyways, gonna put in a couple pictures, then end today a bit early to hopefully get up early tomorrow!

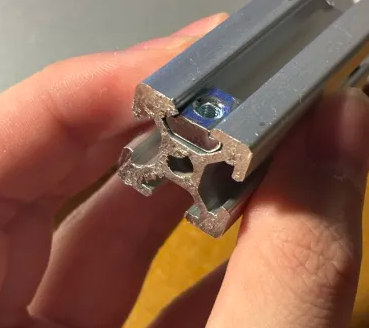
[picture p26: updatelogs/images/202606/06252026 - 1.png]


so, the nuts (t nuts?) do go in!

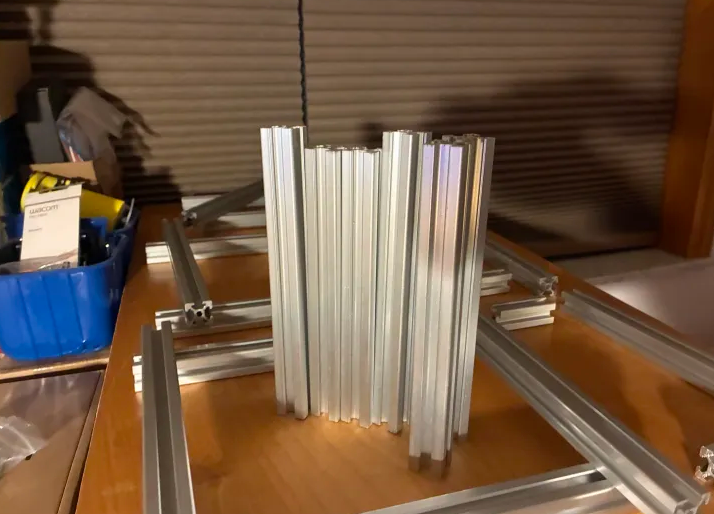
[picture p27: updatelogs/images/202606/06252026 - 2.png]
hmm


yeah, so there's a pretty clear difference in height in some of these

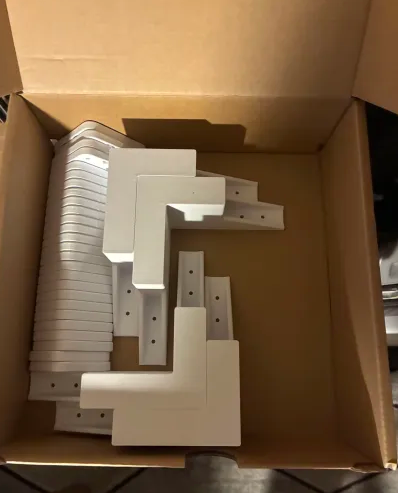
[picture p28: updatelogs/images/202606/06252026 - 3.png]
woo


yep, that's a couple gussets and stands! (two of them were used today for the next image!)

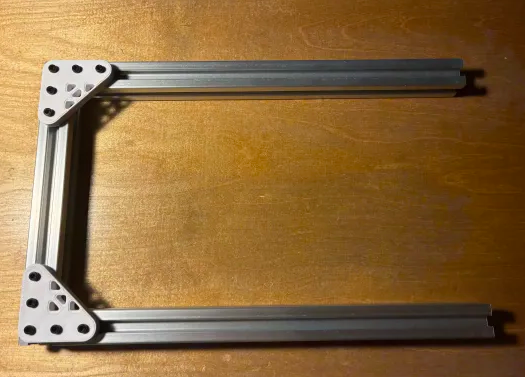
[picture p29: updatelogs/images/202606/06252026 - 4.png]


and that's the current frame progress! i did lose a nut (t nut?) somewhere inside the big storage system area (aka, the table with cabinets and more cabinets acting as tables on the side), idk where it went in there. also, i kinda regret decreasing the clearance for the screws since i actually have to thread them with some effort now lol

anyways yeah, that's it for tonight! it's 12:34 AM, good night!
