HenryLi-0/spark/updatelogs/logs202606/06242026.md

# 6/24/2026 - 61st Update!

as expected, was tired yesterday, decided to take a break for a day. this makes us officially behind schedule! 5:07 PM and we got a bunch to do...

- **OK** - F 6/19/2026: plan and small cad fixes
- **OK** - S 6/20/2026: cad fixes and prepare procedure
- **OK** - S 6/21/2026: cad fixes and prepare procedure
- **NO** - M 6/22/2026: print spreadsheet work
    - exam review day
- **NO** - T 6/23/2026: start printing
    - exam day
- W 6/24/2026: continue printing (gussets), prepare extrusions and rods for cutting
- H 6/25/2026: continue printing (big), extrusion and rod cutting

however, contrary to popular belief, (what???), we can actually start printing like... *checks watch*, now. as in, we can actually start printing the gussets since those are likely not changing anymore, and we can also start preparing the extrusions! just, idk how to properly track this with time other than just constantly writing in here? also, we do need to update the blueprint (just kidding, stardance) site with the updates from the last two days.

anyways, its a good time to mention that it would be nice to reduce the weight on the gussets.

we need x22 corner gussets and x4 three way gussets.

yeah, that'll use a lot of filament... anyways, can this log spreadsheet time too...

setting up lookout or something?

i really dont know how this thing works but sure

ok, back from a quick grabbing of water, idk if i should make the screw hole a bit smaller just so that you have to make some threads manually do that it actually has some strength (but not too much or else it just becomes a pain)

i think changing 0.32cm to 0.3125cm would be ok, since 0.30cm is way too annoying to do (you have to put some effort into it), while 0.32cm just slides sometimes

well, only one way to test, i think im gonna use my white filament for this one, since im completely out of black filament, yellow is also running fairly low, and the extrusions are silver instead of black, but idk

gonna open up blender real quick to see if ill like this color scheme

ok, id say i dont really like it, but its alright since we're trying to do this with what we have (the extruder is probably gonna look the same, idk if i want to do yellow for the gussets since idk if i have 100g+)

ok time to load the white filament while stuff exports, version made!

wait gonna fillet them

ok, red filament put into the box again, does anyone else ever also want an industrial bag sealing vacuum thing?

white filament unboxing time

moving yet more boxes around, wow

so here's the idea, when im gonna be printing stuff, im NOT gonna log in my hours, unless im doing else. personally, i dont think that printing really counts since im not exactly hand crafting or other stuff, but i will just write my observations, since i do think that checking up on the printer and making sure it's not, well, spagetthi (how do you spell it???) is pretty important. however, if im doing something else like cad or something (which i will be for the start), it kinda doesnt really matter and it just works out. anyways, preparing the first print and loading in the filament!

quick photoshoot and loading

hopefully no one noticed someone dropping a piece of strand of pla out their window and into the garden (its biodegradable right? uh oh it doesnt, mustve misremembered oops), kinda feel bad now

ok, sent to print!

6:30 PM, brb

so its shaking like my entire huge storage system thing i have going on in my room, but we're printing!

ok, 6:44 PM, its printed! got the screw and gonna let it cool for a second and test it out, seems pretty good to me!

more bambu studio work, ok, its printing 9 of them now! now i just realized its not gonna look so great with black screws on white pla, but i guess it is what it is (probably shouldve used yellow, but again, itll probably use up most of the filament left)

while that happens, its probably a good idea to start cleaning the extrusions, or do cad work

im a moron i forgot to set the print profile

ok, sent to print again, gonna find a box to store these parts... ok gotta reorganize my table to actually be able to store this, ok, it looks even more like some evil corporation skyscraper complex thing now, idk, print estimates 57 minutes left, im gonna take a quick bathroom break and then start doing cad stuff?

cad time, gonna delay the slider stuff for a bit since its just annoying to deal with lol

some things we need to fix:
- the tall pulley area thingies (the z direction prints at the corners of the coreXY area) could probably be split into multple pieces for better assembly and repair
  - they also take a scary amount of filament to make lol
- the corexy motor rod shaft thing doesnt have a top bearing area for extra support

and the old news of things to fix:
- the z axis doesnt reach the extruder (just increase the bottom thing's height, just some jank cad solution is ok)
- the additional extruder mounts collide with the belt (just put it at a sideways point thing)
- the magnets are not cadded
- **SUPPLY** - we do not have anderson powerpole connectors or anything (find some contact solution? i dont really know how to solve this one)
- **SUPPLY** - there is no heatbed irl (just a buying and manufacturing issue for now)

the aforementioned todo but not urgent list
- add blocks for easier belt pathing in redirect blocks in x rod sliders
- fix -x bearing redirect blocks being a bit too short because of clearances (probably just switching the direction)

oh i got a bunch of mates to fix now in the frame assembly

i messed up the order of the fasten mates on the inside but it still works now, dont really feel like fixing it, more of an ocd thing i guess

ok, 7:39 PM, off to dinner!

hey back at 1:45 AM, ya miss me? anyways, jokes aside, ive just been working on printing today, got 4.95 hrs of printing today, 4.38hrs of which were good prints!

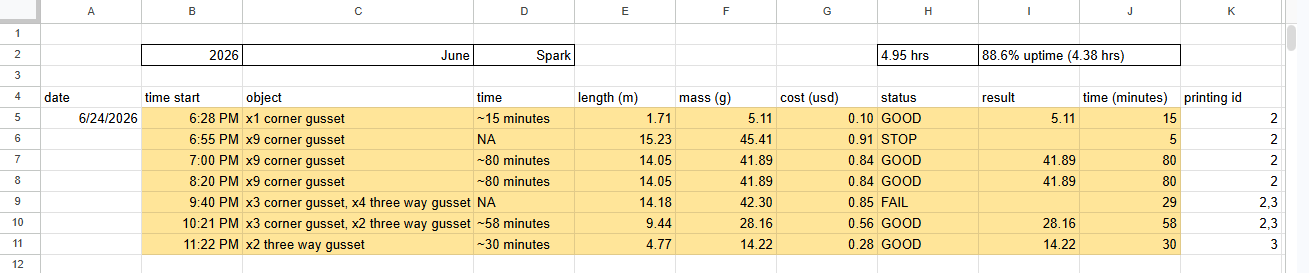
[picture p30: updatelogs/images/202606/06242026 - 1.png]
yay


yep, yet another printing spreadsheet! 

something interesting that came up was this

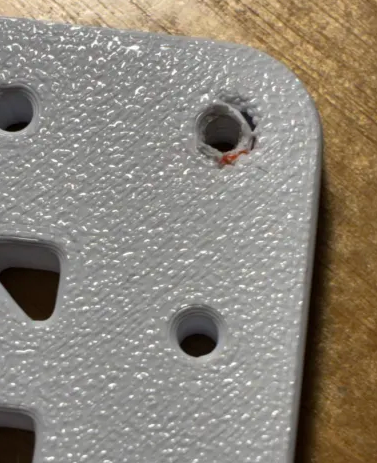
[picture p31: updatelogs/images/202606/06242026 - 2.png]
hmm


idk how its red, since i fully extruded all the red out (and this wasnt the first batch either, at least, i dont think?), so that was a bit weird. probably just some extra debris left over (but i also cleaned the build plate so i dont really know)

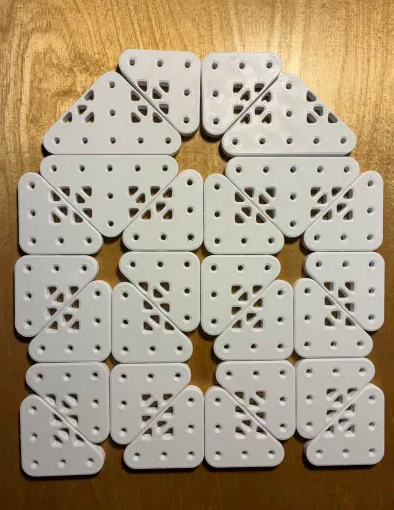
[picture p32: updatelogs/images/202606/06242026 - 3.png]


and theres all the gussets, laid out neatly! these are gonna be holding our frame together! ok, just learned how to put row specific formulas for conditional formatting in google sheets, so thats pretty cool!

oh yeah, and if you want the gussets in a box, here's what that looks like!

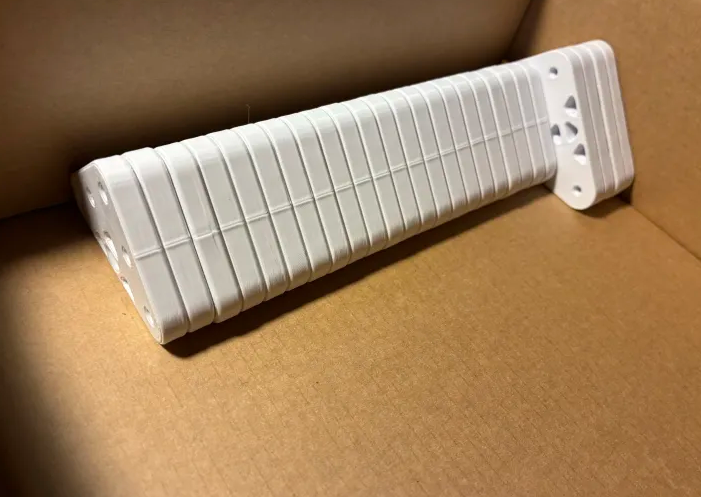
[picture p33: updatelogs/images/202606/06242026 - 4.png]


so yeah, that's kinda it for tonight! gotta get the extrusions ready and hopefully cut tomorrow (well, today, since its 2:05 AM)? idk, kinda gotta speed things up, along with finishing the cad fixes...

well yeah, 2:06 AM, good night!
