HenryLi-0/spark/updatelogs/logs202606/06222026.md

# 6/22/2026 - 60th Update!

ok, so it's currently 3:57 PM right now, just exported the slider and stuff and sent it off to print, im gonna go study and come back some time later, also to discuss the results of testing with it. well, that's it for now, see ya in a sec!

just kidding, 4:00 PM and i just realized that theres a couple improvements that can be made to the geometry, one second... ok, small change made to the latch guide side to help it go in a bit better

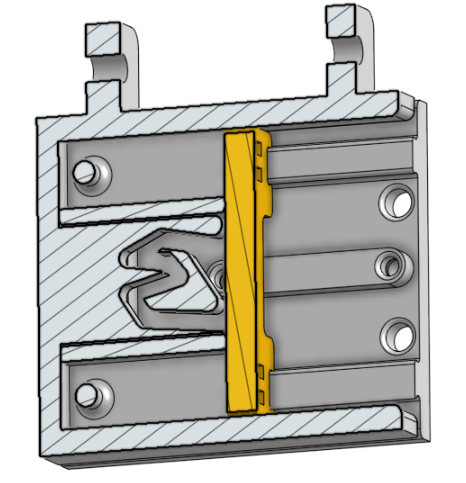
[picture p34: updatelogs/images/202606/06222026 - 1.png]


basically, its just a small adjustment in the little pin area before... wait i just realized, there's something seriously wrong with this, this is NOT the closed state

mfw its still wrong

adjusting the guide once again, and then yet again

now ive just confused myself

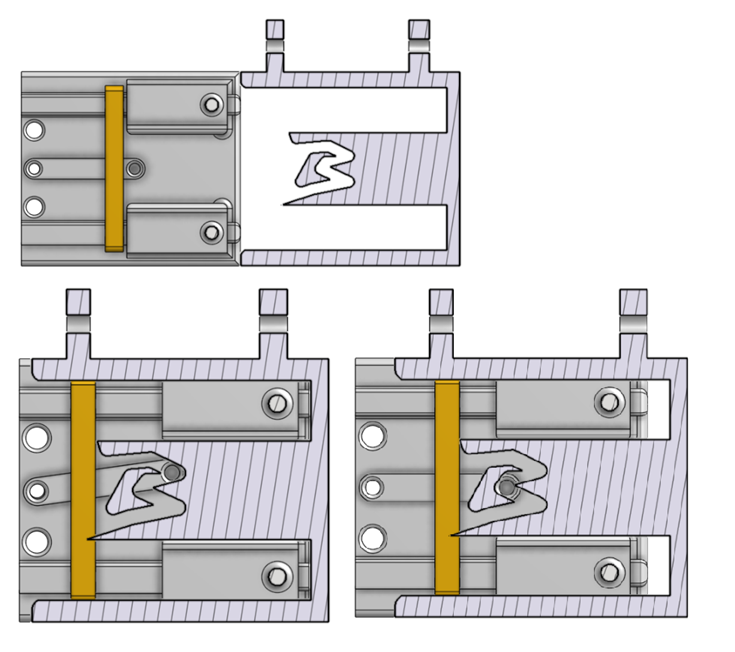
[picture p35: updatelogs/images/202606/06222026 - 2.png]


here's the setup idea, the top represents preparing to connect, bottom left represents almost max distance of the stick pivot thing, bottom right represents the locked state! kinda still editing it a bunch right now

why is onshape export taking so long

ok, 5:42 PM, tons of more updates, think it's ready to print? ok, sent to print, see ya in a bit!

woo 6:17 PM and it's done! gonna see if it works well...

oh i forgot to fillet something so the thing doesnt slide well. i guess its sanding time

ok, so its been like half an hour of playing around with it and here are my opinions:

- slider doesnt lock in (since, it the rails are kinda dont keep it on the track)
- the guide does work, but it gets caught in a couple areas
- assembling is annoying but ok
- the rubber bands would need to be very strong (or just fix the guide chokepoints)
- the slider does not keep the pivot stick forced to the center (just move it and tangent it)
- it's also pretty strong, just doesnt have anything keeping the two sides together (not too big of a deal, but might be an issue later down the line)
- the slider must keep the pivot up, or else its gonna go in the wrong way (and not latch)

ok, it's like 7:00 PM, gonna go to dinner now, probably not gonna do much for the rest of today?

yep, that's it! ok, 12:49 AM, expect things to increase in activity tomorrow afternoon? idk, well, yeah, that's it for now, good night!
