HenryLi-0/spark/updatelogs/logs202606/06212026.md

# 6/21/2026 - 59th Update!

~~haha funny number day~~ (how many years have i done this joke? oh its been three years...)

- https://github.com/HenryLi-0/tape/blob/main/updatelogs/logs062024/06212024.md
- https://github.com/HenryLi-0/epoxy/blob/main/updatelogs/logs202506/06212025.md

hold up, what's epoxy? idk, im not spoiling anything... (idk if itll ever happen)

anyways, it's 5:20 PM now, i wrote a [little script](</updatelogs/words.py>) for word counts, if that's interesting? anyways, all the logs added together is roughly the size of a small novel (~46k words, counting by spaces), which is pretty cool! anyways, back to cad!

yet again, the todo list copied over

some things we need to fix:
- the tall pulley area thingies (the z direction prints at the corners of the coreXY area) could probably be split into multple pieces for better assembly and repair
  - they also take a scary amount of filament to make lol
- **GOOD** - big printer stands could probably be smaller? (scary amount of filament for them)
- the corexy motor rod shaft thing doesnt have a top bearing area for extra support

and the old news of things to fix:
- the z axis doesnt reach the extruder (just increase the bottom thing's height, just some jank cad solution is ok)
- the additional extruder mounts collide with the belt (just put it at a sideways point thing)
- the magnets are not cadded
- **SUPPLY** - we do not have anderson powerpole connectors or anything (find some contact solution? i dont really know how to solve this one)
- **SUPPLY** - there is no heatbed irl (just a buying and manufacturing issue for now)
- **FINE** - the holder thing does not work (just make it work)
  - **FINE** - make actually plausibly functioning latches

the aforementioned todo but not urgent list
- **GOOD** - fix fasten mates for the farthest -x redirect block thingies
- add blocks for easier belt pathing in redirect blocks in x rod sliders
- fix -x bearing redirect blocks being a bit too short because of clearances (probably just switching the direction)

of course, we're still working on the latch mechanism, gonna look into pla springs, then possibly a rubber band solution?

i somehow found a [video](https://www.youtube.com/watch?v=gWreqqYNsBE) of someone turning pla filament into a spring, not exactly what im looking for but still intriguing?

quick watch of [this](https://www.youtube.com/watch?v=wpriGP45Unw) video, i guess imma just make a test print?

im sorry, a 0.4cm spring? i just realized that this makes absolutely no sense, no, springs will not work in this situation unfortunately, its just WAY too small

hmm, just plaayed around with some failed parts in the trash bin and i think it might be better to just do a flexing arm thing and hope it doesn't melt. don't think it will, be hopefully the flex isn't too bad of a problem over time? idk, print layers are currently in our favor right now. but yeah, probably best to just do that at this point.

hmm, the second instagram thing from yesterday uses springs but doesn't have flexing parts, (well, actually, both of them use springs, but this one doesnt flex the connection stick thing). but essentially, for this to work on it's side, we need a constant force pushing the tool away from the lock to actually have the sideways lock function. depending on strategic choices, this can get roughly 0.7cm of spring back and forth action, probably around 3cm long, so that's pretty reasonable? oh yeah, one more thing, the pla does stay at a stretched state when docked, so that's a bit of a concern. (i mean, we can try to figure out how to use rubber bands? that would be an ok idea, actually...)

ok, full redesign time (again)

ok, back from a 10 minute break, time to actual do this

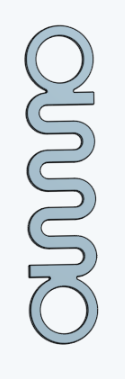
[picture p36: updatelogs/images/202606/06212026 - 1.png]


goofy spring for testing in like a bit

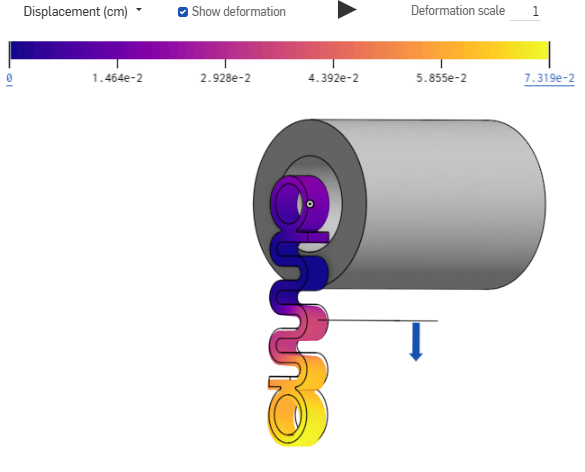
[picture p37: updatelogs/images/202606/06212026 - 2.png]


ok, 3 pounds of force does that, idk what to do with this info, i guess its really strong right now? (this gives no info about flex)

i guess ill just print it out and see

ok, printing now, ok, played with it for a bit, here's my opinions:

- thing does not stretch (without really pulling it)
- thing does not return (probably streetched it beyond its best point)
- thing is really bendy (accidentally turned it into a rod) (oops)

v2 testing, 3 pounds of force should flex 0.4cm

- thing kinda stretches, but barely
- stretched the thing and not it just doesnt go back

yeah, idk what i was thinking, it would be way better to just use rubber bands.

so the design doesnt actually work without flexing plastic aaa

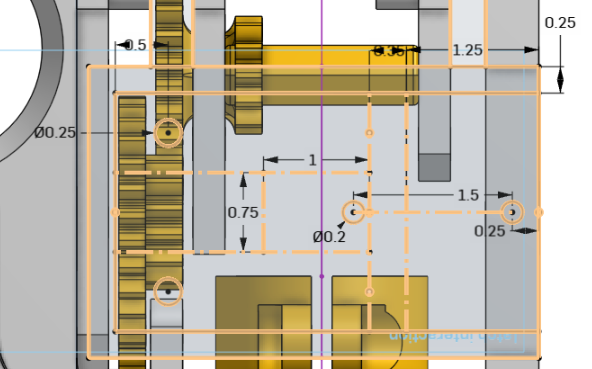
[picture p38: updatelogs/images/202606/06212026 - 3.png]


the problem with this one is that the switch kinda has to stay inside, and that's true with all of them except for the original two lock design thingie from `thang010146` yeah. i guess we can have guide rails

ok

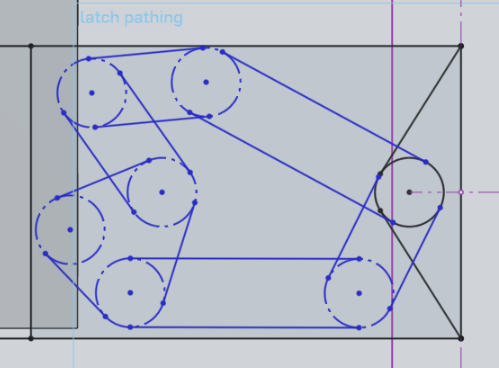
[picture p39: updatelogs/images/202606/06212026 - 4.png]


hmm, ok, yes, i know they are still undefined, but something like that? anyways, 7:26 PM now, gonna go eat dinner, brb!

back at 9:52 PM, yeah, let's just get this done

ok, currently working on the side profile (the front of the tool side), gonna answer a question thats been annoying me for a bit which is if the screw actually goes in on the test plate

good news, it does! though, i think we should make the screw holes a bit smaller since the current 3.2mm slides way too easily (tested it on a 3mm hole, that makes you have to thread it a bit), 3.1mm is probably a good place? idk, might do that later

so, i think we need more space. its just really really really hard to compact this, also since the pin thats moving is 2mm in size and that is no way enough to hold everything up.

me when i do the third redesign in a day

ive just had the best worst idea in a while, what if we just use a small piece of filament as the thing that travels inside, and have the whole thing as its own floating block of sorts, with a stronger side supports for the tiny filament? (and it would be really close so we barely have to care about it flexing?)

friendly reminder that the z axis exists (well, y in this case)

im either locked in or just really confused

ok, i think im ready to start extruding?

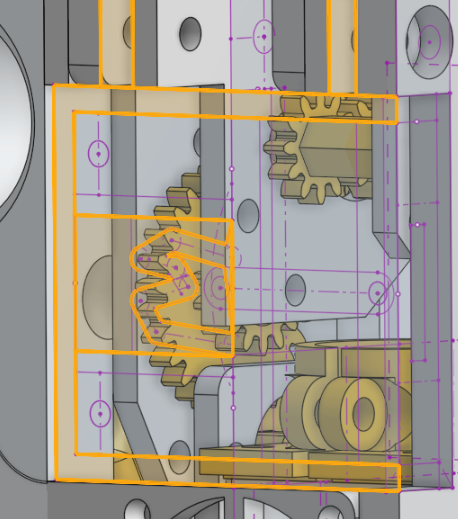
[picture p40: updatelogs/images/202606/06212026 - 5.png]


no clue if that latch path works, but we kinda gotta move on

just checked the todo list and realized i forgot to say that the filament hole thing was complete, oops

someone add 12 rubber bands to the bom lol

i just realized this makes parts float. aaaaa

i shouldve seen that coming. so. idk what to do now.

ok, i just had a bad idea, aka, just invert it, so the guide rails are on the outside instead of the inside

the other side would just be floating then.

aaaaaaa

i guess just one sided? but thats crazy weak

but we do have two sides

i guess so

who are you talking to?

what?

its like youre having a conversation with yourself

thats true

what was that, anyways, back to cad. a bit later, i think this might be some of my worst cad work ive done in a while. ok, so it's been really really really quite a while, here's the progress!

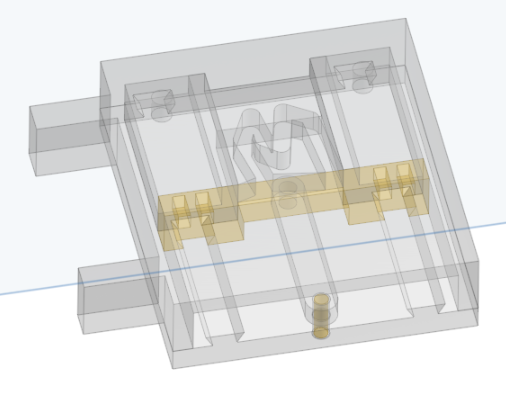
[picture p41: updatelogs/images/202606/06212026 - 6.png]


of course, no fillets yet, but that's the general idea! if you want to see it better, just go to the cad and take a peek! it's probably better than looking at the picture, had to make the parts transparent so it's actually somewhat understandable?

anyways, fillet time! it's 1:03 AM, so let's make this quick! (it probably wont be lol)

ok, part filleted, time to fix the rest of the part studio...

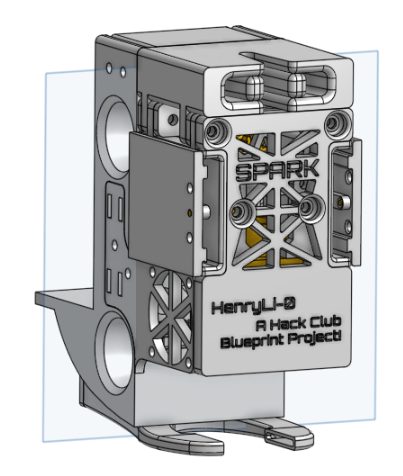
[picture p42: updatelogs/images/202606/06212026 - 7.png]


and there it is!

anyways, assembly time! huh, surprisingly not that many errors! ok, updated them, some strange wakatime error, reloading seems to have fixed it, added a bit of a printability update to the bearing areas so that they are set to tight clearance instead of having zero clearance, so that should be good now?

oh we still need to add the magnets. aaaaa. also the entire docking area. yeah, tomorrow might also just be a cad day, i guess we're not gonna have a print order/assembly procedure. (i also need to study for an exam the day after tomorrow)

yeah, so it's 2:03 AM, i dont think im gonna write a log right now, so yeah. also, fun fact, we still havent solved the axle of the extrusion gearing stuff, along with building 0.7cm OD and 0.3 ID bearings, along with the filament grabbing gears. 

ok, fixed the fasten mates not being perfectly aligned in the far ends, so that's good! unfortunately, (well, its more fortunately), it showed another issue that needs fixing!

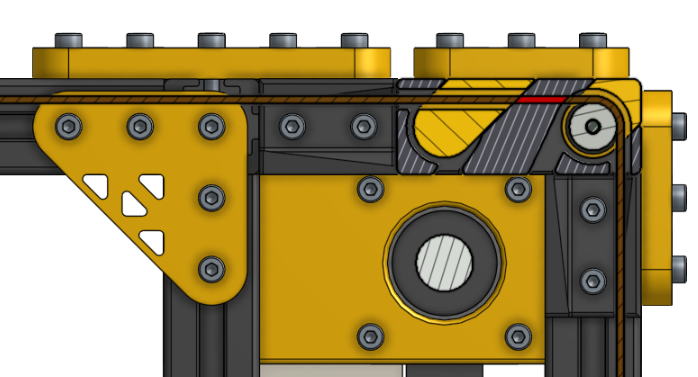
[picture p43: updatelogs/images/202606/06212026 - 8.png]


(you can also see the fixed fasten mate from here!) anyways, yeah, need to fix that...

ok, shouldn't be a big issue, ok, fixed now! yeah, it was just one clearing extrude that just didnt have that selected, oops 

just did a collision check, nothing really unexpected (except for the -x side stacks being a bit too small because of the tolerance thing so the bearing stack is kinda sticking out a bit, not really a big issue though)

ok, updated the todo list, and yeah, it's currently 2:31 AM, good night!
