HenryLi-0/spark/updatelogs/logs202606/06202026.md

# 6/20/2026 - 58th Update!

ok, today's cad work day! it's currently 9:55 PM, starting things up!

updated todo list from yesterday, copied over!

some things we need to fix:
- the tall pulley area thingies (the z direction prints at the corners of the coreXY area) could probably be split into multple pieces for better assembly and repair
  - they also take a scary amount of filament to make lol
- big printer stands could probably be smaller? (scary amount of filament for them)

and the old news of things to fix:
- the z axis doesnt reach the extruder (just increase the bottom thing's height, just some jank cad solution is ok)
- the additional extruder mounts collide with the belt (just put it at a sideways point thing)
- the magnets are not cadded and the filament has no where to come out of (just make a hole on the top and a sliding thing in the main triangle, i guess that also helps with possibly slanted alignment)
- **SUPPLY** - we do not have anderson powerpole connectors or anything (find some contact solution? i dont really know how to solve this one)
- **SUPPLY** - there is no heatbed irl (just a buying and manufacturing issue for now)
- the holder thing does not work (just make it work)

the aforementioned todo but not urgent list
- fix fasten mates for the farthest -x redirect block thingies
- add blocks for easier belt pathing in redirect blocks in x rod sliders

so, we dont really have too much to, never mind we have a lot to do. anyways, question now is how the heck do you make a working spring (???) mechanism here, or at least a working latch setup thing

wait i remember finding something while on instagram... ah, [here](https://www.instagram.com/reel/DZU9sy9yBMv/) and [here](https://www.instagram.com/reel/DQ__PV3DohT/)! compared to the version from `thang010146` (with [this](https://www.youtube.com/watch?v=IUNgQ1GLz2Q) video), it has objectively less moving parts and one less spring. however, it also relies on the flex of a part (and, if you know pla, along side a possibly hot extruder area, would probably melt/flex). thinking about it a bit more, it probably makes more sense to have `thang010146`'s design, since it's better against gravity? but is it? ok, after watching the video again, its probably actually better since the springs have a default state of going to their usual position, whether it be with a tool attached or by itself. that's good since it means nothing (in theory) is flexing at any time other than going in or out. that's good!

now, how to translate this to cad... i was gonna make a practice cad but i guess the best move is to just go for it at this point. anyways, if it wasn't obvious, the spring part is gonna be the part mounted to the docking bay, and the "stick with a slider" is the part on the tool head. now, i dont want it awkwardly sticking out, so we'll have to figure that out somehow

anyways, to the cad!

ok i think im just gonna nuke this entire section, 10:16 PM, 158 total features right now (just some notes in case i need to time travel)

i got an idea

gotta check the extruder can go that far first, but im thinking the it should be capable of sliding in through the side, which would also help with the stuff sticking into the main area from yesterday's idea (though it wasnt an issue, its just a bit unsettling)

hmm this might actually barely work? just checking if its capable of the position first... after testing it in microsoft paint, then in actual cad, it might actually work!

here's my idea so far

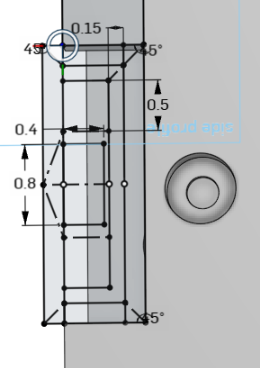
[picture p44: updatelogs/images/202606/06202026 - 1.png]


just measured a screw's top, it's like 0.5cm in diameter. anyways, there's the center part (included in the sides of the tool), where the sliding bit will be located (currently the 0.8x0.4cm thing in the center), with the side measure of 0.5 being the spring area and stuff, still need to sort out the middle bit, writing that out made me realize i got quite a bit to fix

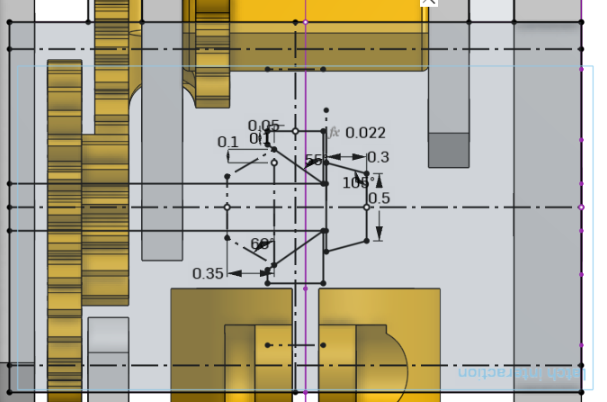
[picture p45: updatelogs/images/202606/06202026 - 2.png]
waw


ok, 11:24 PM, here's the current status of stuff! as you can see, theres the sliding bit and the locking things, idk how to do the spring stuff (or if it'll work, that whole space is so small that i might need actual metal springs instead of 3d printed?) (its 0.6cm to 0.45cm, rounding of course), gonna watch a movie, brb!

back at 1:38 AM, ok, did some cad work, now im thinking, what if we just used rubber bands to force the sliders to the center instead of having springs on the outside? it would save on a bunch of space and make the connection way bigger, but im also not sure if i have rubber bands (well, that should be least of my concerns), and if it would work? oh wait, gravity exists? idk, it could also be counteracted

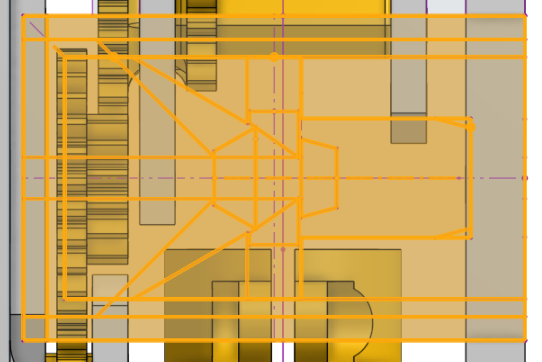
[picture p46: updatelogs/images/202606/06202026 - 3.png]


anyways, thats what it looks like right now, you could probably guess whats what. ok, more side profiles tomorrow i guess, it's pretty late right now?

ok, it's currently 2:00 AM now, good night!
