HenryLi-0/spark/updatelogs/logs202606/06192026.md

# 6/19/2026 - 57th Update!

ok, let's do this! it's 10:49 PM, and a week passed (somehow???)

anyways, we still have a ton of cad work to do, the goal is to finish this one in two weeks. that's gonna be... hard. but we already wasted one so idk

here's the plan:

- F 6/19/2026: plan and small cad fixes
- S 6/20/2026: cad fixes and prepare procedure
- S 6/21/2026: cad fixes and prepare procedure
- M 6/22/2026: print spreadsheet work
    - exam review day
- T 6/23/2026: start printing
    - exam day
- W 6/24/2026: continue printing (gussets), prepare extrusions and rods for cutting
- H 6/25/2026: continue printing (big), extrusion and rod cutting
- F 6/26/2026: continue printing (tool base), assemble base frame
- S 6/27/2026: continue printing (tools), extruder and heat bed assembly
    - expected doctor visit
- S 6/28/2026: continue printing (big), electronics assembly and check
    - expected doctor visit
- M 6/29/2026: continue printing (anything else), corexy assembly
- T 6/30/2026: find a print bed thing
    - requires going outside
- W 7/ 1/2026: assembly day
- H 7/ 2/2026: final checking day and live electronics check
- F 7/ 3/2026: programming and testing day
- S 7/ 4/2026: programming and testing day
- S 7/ 5/2026: ship day

so we have an incredibly packed schedule. yeah. obviously, the printing stuff shouldnt take 6 days, but idk when the summer job stuff starts so yeah.

anyways, we dont have much time to fix the cad, actually, who am i kidding, i just really need to lock in to make this work. anything special about any particular day is under the date as a list thing, and yeah, i should really try to be able to stay ahead of schedule. you know what, let's make those due dates! anyways, we still have a huge list of cad issues to fix, 11:10 PM right now, music is blasting in my ears (this cant possibly be good in the long term, right?), let's go!

reference the list from 6/12/2026 to follow along! actually, imma just put it down there...

some things we need to fix:
- **DONE** - the bearings are actually 4mm (???) instead of 3mm, so we just have bigger bearing stacks (not sure if thats really an issue in belt alignment)
- **FINE** - some stuff (aka, specifically printing rods sideways) doesn't come out the best (a bit of superglue and friction should be able to keep everything together?)
- **DONE** - the printed gussets are a bit too short (since, the screws currently will poke a little bit into the frame, see a picture coming some day)
- **FINE** - some of the extruder plates are goofy as heck (since the screw holes are wayyy too close to the edges, probably just increase the size)
- **FINE** - some of the extruder plates also either dont have screw top areas or are just plain impossible to put in
  - **GOOD** - small area near extruding part
  - **FINE** - top screw in area
  - **GOOD** - collision with front
- the tall pulley area thingies (the z direction prints at the corners of the coreXY area) could probably be split into multple pieces for better assembly and repair
  - they also take a scary amount of filament to make lol

and the old news of things to fix:
- the z axis doesnt reach the extruder (just increase the bottom thing's height, just some jank cad solution is ok)
- the additional extruder mounts collide with the belt (just put it at a sideways point thing)
- the magnets are not cadded and the filament has no where to come out of (just make a hole on the top and a sliding thing in the main triangle, i guess that also helps with possibly slanted alignment)
- **SUPPLY** - we do not have anderson powerpole connectors or anything (find some contact solution? i dont really know how to solve this one)
- **SUPPLY** - there is no heatbed irl (just a buying and manufacturing issue for now)
- the holder thing does not work (just make it work)

the aforementioned todo but not urgent list
- fix fasten mates for the farthest -x redirect block thingies
- add blocks for easier belt pathing in redirect blocks in x rod sliders

ok, gonna tackle the gusset thing first since it seems the quickest, got a screw and a nut and a test gusset here, ok, 1mm should be good enough, according to the calipers, so 

8.8, 12.8, 4.0, 2.8

idk what these numbers mean anymore, but 6mm should be perfect? idk, im just gonna do 6.5mm just in case

ok, yeah, idk why im overthinking this

working on the tool and the screws on it, did something weird

ok, been busy on cad, havent been writing much, here's a quick picture!

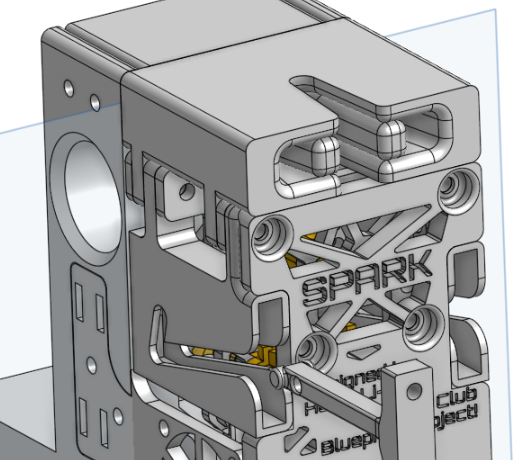
[picture p47: updatelogs/images/202606/06192026 - 1.png]
waw


yep, the filament thing is solved! also a couple of weird fillet and screw things! reminder that all the 16mm screws in there are actually 14mm! (i should probably make a part studio and just make one myself...)

anyways, its getting a bit late, but ill try to work on the docking bay stuff now?

ok, it's 1:30 AM now, i think im gonna go to bed now, not too much progress on extruding the stuff for the docking bay, im thinking of just redoing the entire part studio?

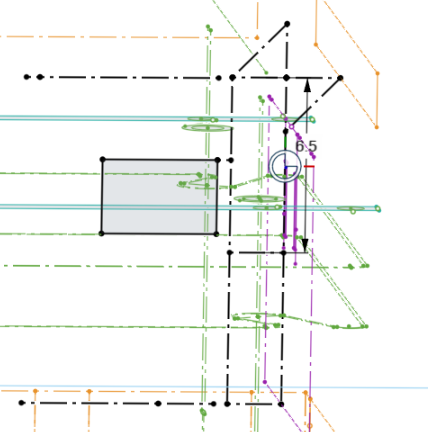
[picture p48: updatelogs/images/202606/06192026 - 2.png]
hmm


here's how it currently looks like in the mastersketch! so the fixed version is just gonna stick out over there instead. well, that's it for today! pretty productive but still a bit to do. in the end, the little connecting bit might just have to stick out like 1.5cm or something from the area above the electronics area (including the extrusions), but thats probably fine? (it doesnt collide with the tool while printing so...)

anyways, we also need to work on the connection thing but on this side since, well, its probably just best for it to actual connect? however, i just realized that doesnt make sense since the tool would never move by itself. hmm... currently, its gonna float, so i guess we'll need a locking hook and one to stop it from rotating? (or, just put it flat against the wall)

i guess to work on the docking bay we first have to solve the docking piece (the click and lock and click and release mechanism thing)

hmm

well, that's some thoughts for another day! (hopefully tomorrow?) ok, it's 1:38 AM now, good night!
