HenryLi-0/spark/updatelogs/logs202606/06122026.md

# 6/12/2026 - 56th Update!

ok, it's currently 1:21 PM at school, and i gotgithub, hackatime, and onshape, all set up (and theoretically configured?) on a random school laptop. anyways, welcome back! not gonna be back for long since i do have exams upcoming. anyways, im currently in physics and since we're done with anything, our teachers letting us do whatever, so here we go!

the last couple days, ive been testing 3d prints here and there, just seeing clearances and how good stuff prints out was pretty interesting to do, ill add a couple pictures when i get home (if i remember)

anyways, spent a minute because some guy asked me to beat deadlocked, 61% first run, messed up because i started stressing a bit (my fingers are shaking lol) (this guy has a black wave trail and is somehow zoomed in, thats an interesting setup)

some things we need to fix:
- the bearings are actually 4mm (???) instead of 3mm, so we just have bigger bearing stacks (not sure if thats really an issue in belt alignment)
- some stuff (aka, specifically printing rods sideways) doesn't come out the best (a bit of superglue and friction should be able to keep everything together?)
- the printed gussets are a bit too short (since, the screws currently will poke a little bit into the frame, see a picture coming some day)
- some of the extruder plates are goofy as heck (since the screw holes are wayyy too close t the edges, probably just increase the size)
- the tall pulley area thingies (the z direction prints at the corners of the coreXY area) could probably be split into multple pieces for better assembly and repair
  - they also take a scary amount of filament to make lol

and the old news of things to fix:
- the z axis doesnt reach the extruder (just increase the bottom thing's height, just some jank cad solution is ok)
- the additional extruder mounts collide with the belt (just put it at a sideways point thing)
- the magnets are not cadded and the filament has no where to come out of (just make a hole on the top and a sliding thing in the main triangle, i guess that also helps with possibly slanted alignment)
- we do not have anderson powerpole connectors or anything (find some contact solution? i dont really know how to solve this one)
- there is no heatbed irl (just a buying and manufacturing issue for now)
- the holder thing does not work (just make it work)

and probably a whole bunch of things that im forgeting

i also need to start assembling some form of print spreadsheet for the order of stuff to print in, since i also do need to work on the mini robot models (maybe push this into the summer? idk)

well, no time to waste, let's go! gonna tackle the bearing stuff and the extruder holders first, that'll probably take all the time? of course, future photo updates some time, gonna be busy studying for stuff tonight because of wonderful time management (sarcasm detected)

spent a good chunk of time trying to fix something with the +x -y pulley area, kinda weird but whateve, need to update the side heights now

ok, 2:10 PM, class is ending any second, got really caught up in fixing frame stuff, but yeah, see ya for now!

so its 12:37 AM, so you're telling me 10 hours passed? that's some interesting time flow, anyways, photos incoming!

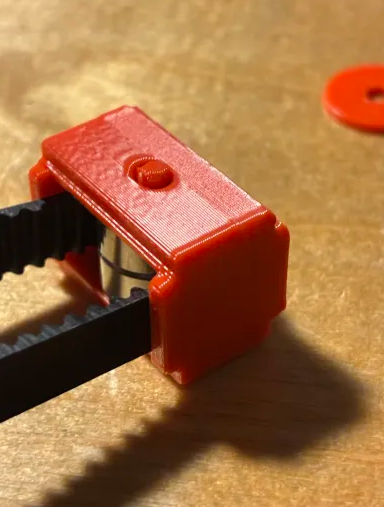
[picture p49: updatelogs/images/202606/06122026 - 1.png]


well, that's one of our parts. so, glancing to the corner, you probably notice that there's one of the washer looking things (they function more as checks to make sure the belts dont fall off the stack), but the real question is why they're there. In simplicity, the bearings are 4mm tall, not 3mm, so that needed some fixes. (still working on this!)

however, through the test (there was actually a previous one that was discarded since the shaft didnt fit, that has now been fixed with the printing clearnaces and things), it did show that the belt did move pretty nicely with the bearing stack, so that's good.

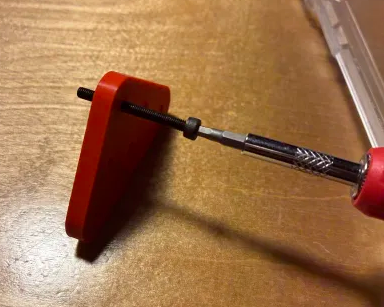
[picture p50: updatelogs/images/202606/06122026 - 2.png]


ok, ignoring the floating screwdriver, the screw actually went into the hole really nicely! might consider decreasing the hole size (3.2mm iirc) just by a little so that theres actually some threading to be done (it's actually probably just fine for now, really)

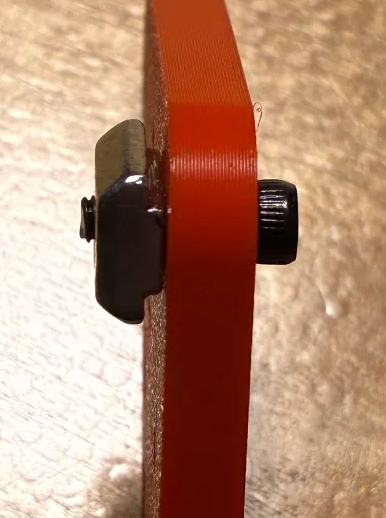
[picture p51: updatelogs/images/202606/06122026 - 3.png]


look at that! it actually goes through! anyways, i currently have two issues with this! firstly, the obvious one, that screw's going inside the extrusion right now, which is rather unpreferable. anyways, second issue is, how are we gonna get the extrusion screws to align with the frame? idk. maybe print some spacers or something, but yeah, got no clue how to solve that one

shall we check up on the cad real quick? yeah, that seems like a good idea! need to do a couple version history visits to make sure i didnt break the bearing stacks and slider setup on the +x side. good news! it seems fine, it just looked a bit goofy without the bearing stacks

i was gonna say the problem was fixed, then remember the x rod sliders (also, another thing, not too important, but some of the redirect block things (specifically on the farthest -x side) are just the slightest bits misaligned, which is a bit annoying, but not too important right now)

wow, that was solved way faster than the other one... oh error found in checks

putting the belt in is going to be a real pain... anyways, maybe add extra blocks to the future todo but not urgent list

the aforementioned todo but not urgent list
- fix fasten mates for the farthest -x redirect block thingies
- add blocks for easier belt pathing in redirect blocks in x rod sliders

anyways, here's the current cad fixes! so the belts should be good now, at least for the bearing stacks (we still need to tackle the clipping issue)

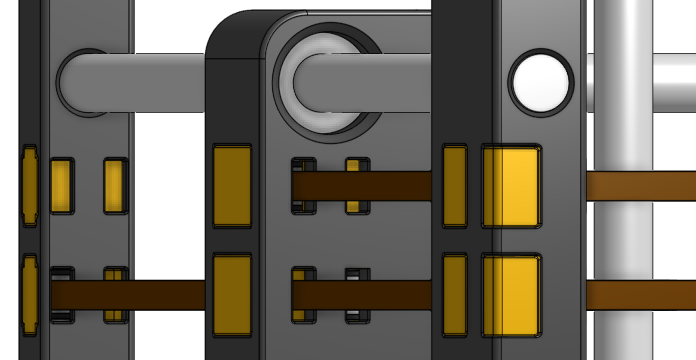
[picture p52: updatelogs/images/202606/06122026 - 4.png]
yay


yeah, that's pretty much it for now! it's getting a bit late now, being 1:41 AM, so yeah, gonna have to head off to be now, since i do have an very important exam upcoming this sunday, so im probably gonna disappear until sunday's afternoon (or maybe next tuesday/wednesday when school ends?)

well, i was about to start closing stuff and then i realized the extruder pocketing was broken and now im back to fixing stuff

ok, that's fixed now! wow, randomly printing the back plate really saved me here (idk something messed up the size of the back plate, which was what messed up the extruder pocketing), updated to not really care and actually decide in there, also made it a bit wider! speaking of which, i should probably do that picture real quick

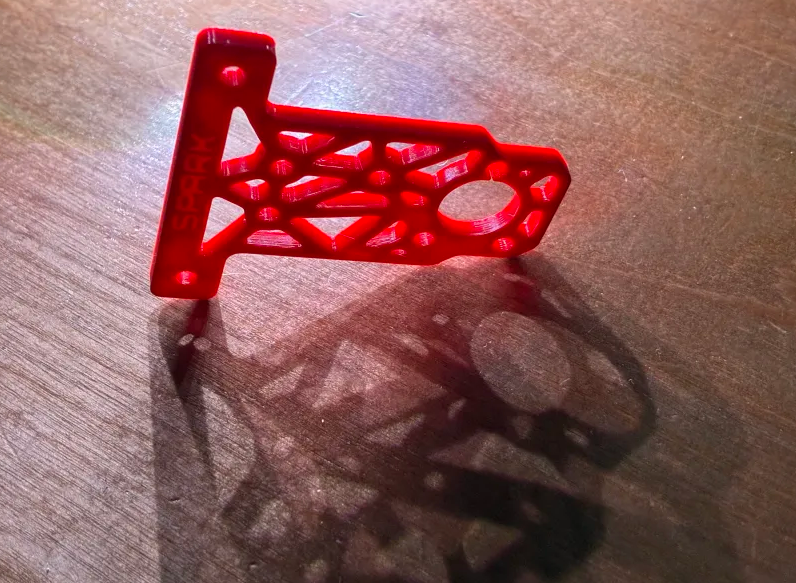
[picture p53: updatelogs/images/202606/06122026 - 5.png]


why is it so cinematic? idk, but if you look a little closer near the main connection hole, you might notice a little break where one of the connections just breaks a bit too close there, yep, that's also been update now! not sure if it'll print right, but thats a future thing.

anyways, i should probably be heading off to bed now. ok, 2:16 AM now, good night!
