HenryLi-0/spark/updatelogs/logs202605/05242026.md

# 5/24/2026 - 54th Update!

3:04 PM, welcome back! it's been a bit of a week, didn't really feel like really buying stuff on the weekdays since those logs would be awfully short (and since it didnt really make sense to do that without a whole day). i have been looking at random buying stuff throughout the week, but whatever, let's get back to this! here's the plan for today:

- bom fixes (see the log of 5/16/2026)
- assemble buying order (so we dont mess it up and do the 1/per correctly)
- confirm checks (double check)
- bom buy (buying everything in order)

it's been 20 days (+/- 1 day) since the grant, so we better finish this soon, ideally with stuff arriving some time this week (maybe the aliexpress stuff next week) and yeah! hopefully no world wide conflict or supply issues appear out of nowhere (this is NOT foreshadowing (please please please))

so, what are we waiting for? (also, [here](https://www.amazon.com/Linear-Hardened-Chrome-Motion-Printer/dp/B0CW9JWNJB/)'s another backup for the linear rods i found just earlier)

to fix (from 5/16/2026):
- FIXED - no amazon linear rods (motion, row 2), out of stock (wait/replace)
- NOTED - xy belt pulley (motion, row 6), need 2, limit 1, stock 1 (replace)
- NOTED - z screw (motion, row 7), limit 1
- NOTED - 623 bearings (motion, row 9), limit 1
- NOTED - triangle lab v6 hotend (extruders, row 2), limit 1
- FIXED - skr 1.4 turbo (electronics, row 8), does not exist anymore (replace)

ok, not much to fix, just noted if its limit 1, just hoping that its because of the 1 time thing

well, that's it! not sure if i should just buy the stepper motors first to get the sale to go through or to assemble stuff first?

eh yolo whatever (haha get it like the object detection? ok)

ok, everythings been compiled to a list, assuming that the multiple buy thing is just because the deal is there (because, theres no way they want us to buy screws one pack at a time, eight times?)

so... mightve missed the additional charges on the stepper motors, just $3.55 now, hopefully doesnt bite us later on?

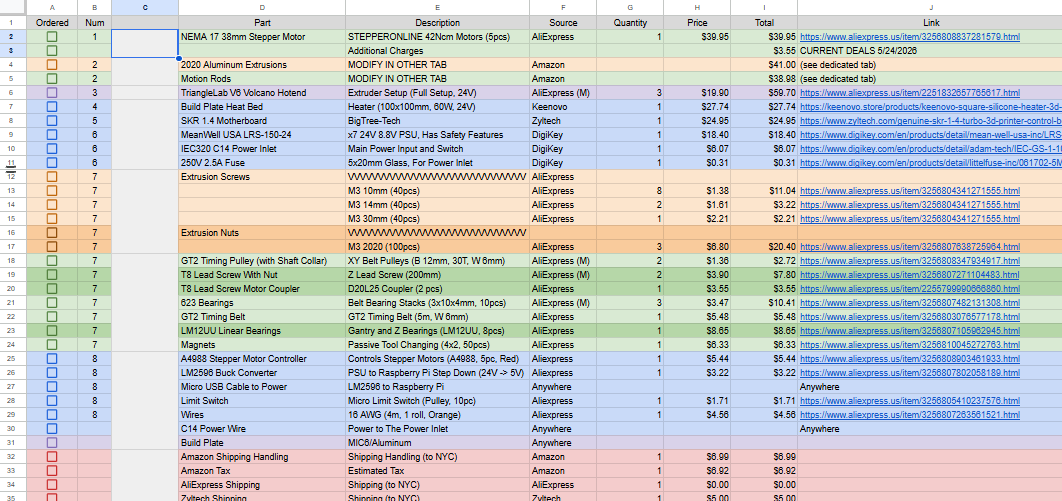
[picture p54: updatelogs/images/202605/05242026 - 1.png]
hmm


ok, 4:05 PM now, time to start it i guess, now or never!

waw

wow, raven flashbacks...

ok, stepper motor bought!

so, it seems that amazon doesnt charge until shipped. hmm. eh, got the invoice ready anyways, got that information from the hcb channel on slack, was terrified for a couple minutes lol

note to self: check you have $94.68 or more at the end of today

as expected, the limit for 1/shopper on aliexpress was just because of the deal! no issues with limits now, it seems! (hold on a second, shouldnt i still have a deal since it didnt really apply on the stepper motor...)

now, not sure which extruder type to get (as in, all metal, 4.1mm, ptfe lining?), but i guess 12V vs 24V is more important to settle

LRS 150-24:
- 24V, 6.5A = 156W
- heatbed is 24V, 60W
- remaining 96W for rest and extruder?
- skr 1.4 is capable of "12/24V DC", given "12/24V DC" in
- 24V seems good
- v6 allegedly 40W?
- 56W for motors, should be more than enough?
- also, this is worst case, they probably wont be consuming max power at all times
- A4988 allegedly not optimal for heat and stuff, but its fine

ive been told to do all metal i guess, so 24V, all metal

i randomly searched coupon codes for aliexpress, copy pasted the one from the overview thingy and somehow it works, thanks i guess?

ok, hotends ordered!

5:30 PM, gonna take a quick break

ok, 6:01 PM and back! cleaned up a table and watched an episode of another series, time to get back to ordering!

so the trick appears to just search up "BRAND promo codes" and just try the ones in the overview, just found one for zyltech (shouldve tried for keenovo but whatever)

digikey time! saw yall at worlds by the way, got two of your pcb rulers for free! thanks!

wha

come on

waiting on digikey invoice, was quite pricy, $14.84 on taxes and tariffs and shipping

so uh, the things charged but its still processing on digikey's end, can seem to find the invoice?

ok, 7:15 PM now, just ordered set 7, one more to go! as in, one more to go later on, gotta go to dinner! anyways, this one just has a ton of reciepts i need to upload (either 6 or 8?) so yeah, gonna check digikey one more time, hmm nothing yet, ok, see ya in a bit! quick commit...

ok, 9:53 PM now, let's get this last order in! just kidding, we have some reciepts to file... ok, seven minutes later and thats done! digikey seems to still be processing or something, idk, waiting for the invoices tab to load now, we seem to be on track to have $13 left, spending a total of roughly $385, not considering additional charges or coupons yet

yeah, no invoice just yet

ok, a while later, last order going in!

ok, last reciepts in, spent $388.29, remaining $10.38, current balance $105.06 (waiting for amazon to charge), waiting for digikey invoice, but other than that, just waiting for shipment! good thing we got those coupons, saved a total of $16.25 (we wouldve gone over)

so, what now? well, just waiting for the digkey invoice and shipment (oh ive already mentioned that whoops), i guess that's it for now? probably should update the bom and readme with this info, eh, maybe a different time. obviously, the extrusion cost increasing by like $10 wasnt optimal, but yeah, it is what it is.

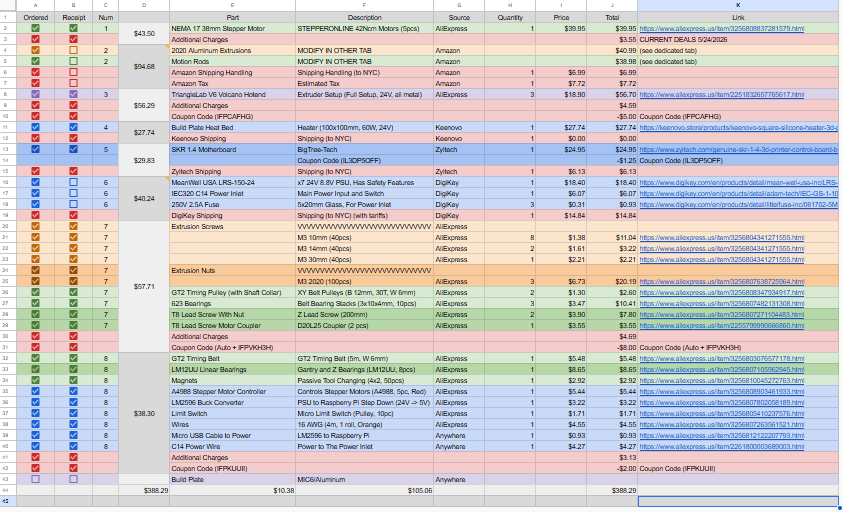
[picture p55: updatelogs/images/202605/05242026 - 4.png]


got anymore of those pixels? anyways, if you want a bigger picture, just check out the spreadsheet!

ok, 10:52 PM, gonna go watch a movie!

ok, 12:51 AM, just finished, neat movie! also, perfectly timed...

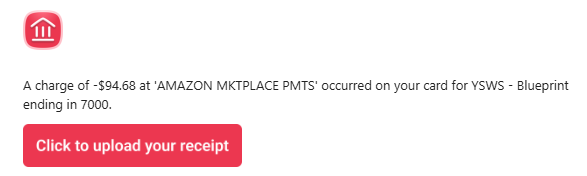
[picture p56: updatelogs/images/202605/05242026 - 5.png]
yay


yep, amazon just went through! ok, nothing from digikey just yet, yeah, nice to see things are flowing through, amazon is expecting to get it delivered on wednesday or something, so, neat!

ok, 1:03 AM, good night!
