HenryLi-0/spark/updatelogs/logs202604/04052026.md

# 4/5/2026 - 50th Update!

welcome back! yes, i took a bit of a break, was just really tired recently (probably because of the triple 2 hours of sleep days i pulled off)

well! 2:40 PM now. (also, watched zootopia 2 the other day, ties pretty nicely with the first, gonna rewatch it sometime soon)

so today i was actually intending on working on the blender render, but we still have a couple CAD fixes first. additionally, wiring diagram is WAY overdue! hit the music!

oh yeah i think i forgot to submit the digikey shopping cart (i spelled that as kart first oops) image when submitted oops

ok, main inlets wired up! big thanks to the voron v0.2r1 assembly manual for references (getting shocked is not on my todo list)

and with that, we're mostly done! gonna do some more wiring...

4:00 PM brb nvm gotta go to the dentist

6:09 PM and back!

well, [wikipedia's awg article](https://en.wikipedia.org/wiki/American_wire_gauge), we meet again.

ok, so we migggght need a couple more parts (yes, updating the bom, shocking, we also still need to recalculate all of it)

pro tip: do not draw hexagon grids by hand. it is not fun for your hand. anyways, one too many hexagons later, i think we're ready?

well, 7:15 PM, and here's where its at! (wait gonna retrace some stuff real quick)

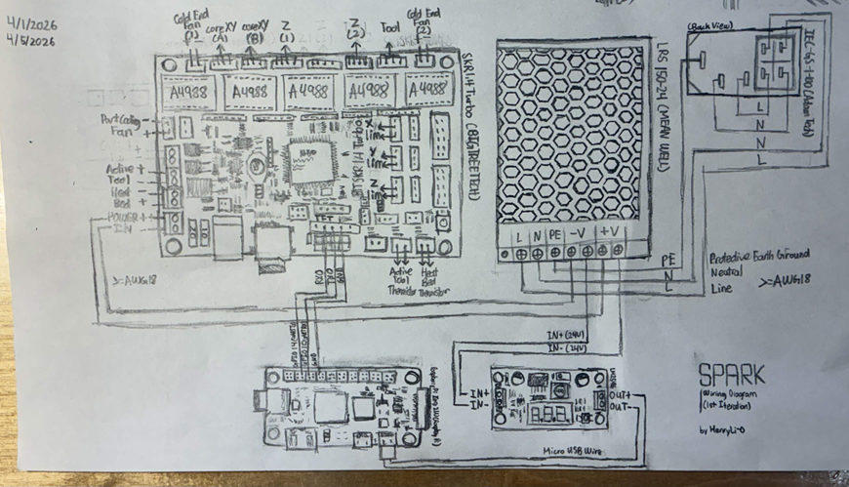
[picture p57: updatelogs/images/202604/04052026 - 1.png]
waw


that's right! i took a bit of time to draw most of the components on each part! (yes, i know, the paper is a teeny bit crumbled so its a bit unsatisfying)

ok, quick commit!

ok, so we have to now write... yeah. oh yeah, i need to update the bom

ok, updated in the spreadsheet, we need to recalculate all of that next! ok, 7:43 PM, off to dinner, brb! (oh yeah, we might also need to find another place to get the SKR 1.4 Turbo, since idk if zyltech is gonna restock soon)

back at 12:41 AM, yeah we're gonna finish that tomorrow morning, and write logs, then head off to robotics for our regional competition (2026nyn2)! ok, good night!
