HenryLi-0/spark/updatelogs/logs202604/04012026.md

# 4/1/2026 - 49th Update!

im sad to say this, but this will be the final log, since i will be deleting the repository after this

just kidding, yeah, its april fools day, but in all seriousness, lets get the electrical wiring diagram stuff done today, started for like half an hour yesterday, gonna continue today, its 11:09 PM, lets go!

(no, you wont be getting many pictures or timelapses since im drawing it on paper)

watched a good portion of [this video](https://www.youtube.com/watch?v=-Gdk0wHg51w) and realized its not exactly about wiring (but still useful, nonetheless)

oh yeah [heres](https://github.com/bigtreetech/BIGTREETECH-SKR-V1.3/blob/master/BTT%20SKR%20V1.4/BTT%20SKR%20V1.4%20Instruction%20Manual.pdf) the instruction manual

ok, skr should be drawn and labeled? not sure what the usb is for

ok, 12:38 AM, still working on getting the PSU connected to the outlet and stuff, still need to get more wire size specifications, but SKR 1.4 turbo bit should be mostly done?

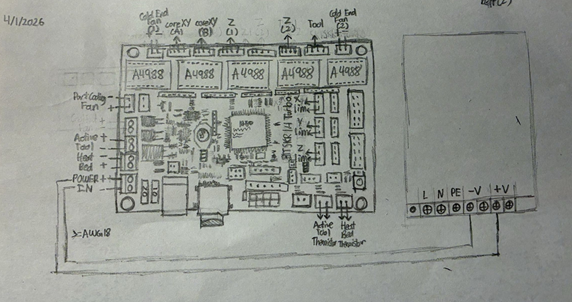
[picture p58: updatelogs/images/202604/04012026 - 1.png]
hmm


well, thats it for today, good night!
