HenryLi-0/spark/updatelogs/logs202603/03312026.md

# 3/31/2026 - 48th Update!

well, lets get into it! 5:20 PM here in NYC, blueprint ends in 6 hours and 38 minutes (im assuming it goes to 11:59 PM?). well, not a second to lose, lets get into it!

- 5:24 PM - 5:30 PM: Fix collision issues
- 5:30 PM - 6:30 PM: Work on Docking Bay and Check Collisions
- dinner sometime here
- 7:30 PM - 7:45 PM: Overall CAD Full Assembly (clean up)
- 7:45 PM - 8:30 PM: Overall CAD check for any impossible actions or major issues
- 8:30 PM - 9:00 PM: Wiring check and making sure we are rated properly
- 9:00 PM - 9:15 PM: Firmware review (klipper) and check that everything is compatible
- 9:15 PM - 10:45 PM: Finish BOM (reduce BOM, use deals/remove some parts if needed)
- 10:45 PM - 11:15 PM: Add some logs back
- 11:15 PM - 11:45 PM: Clean up repository, tidy stuff up 
- 11:45 PM - 11:50 PM: Ship!

completely unrealistic timings, but sure

ok, screw in extrusion fixed now, theres also an issue of onshape updating being slow

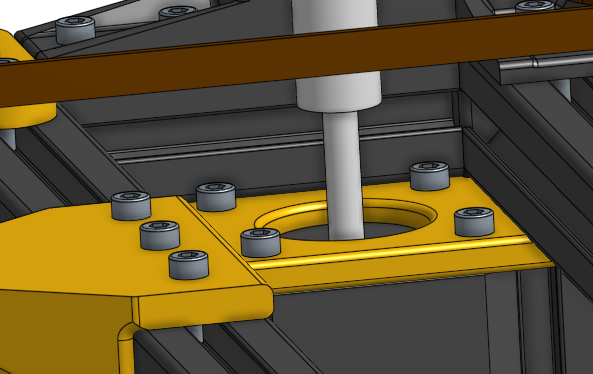
[picture p59: updatelogs/images/202603/03312026 - 1.png]
yay


oh we forgot about z axis stuff, and magnets for the docking stuff, the screws are, in fact, not magnetic.

onshape is definitely being silly right now, everythings shifted but it thinks the distance is zero, thats weird

forced regen, seems to fix stuff

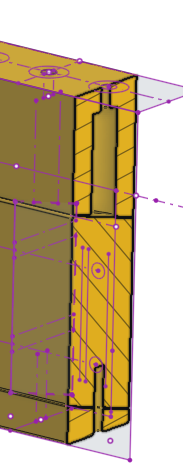
[picture p60: updatelogs/images/202603/03312026 - 2.png]


ok, so thats pretty good, just not sure how to parametrically make that work

ok, just using exact numbers in the assembly for now

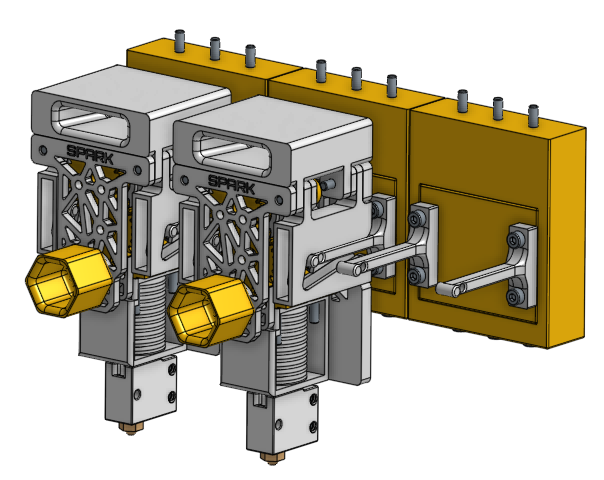
[picture p61: updatelogs/images/202603/03312026 - 3.png]


so, yes, you do need an allen key to put the top screws in, but its fairly visible, structurally, that bits a bit weird, should be fine though with good printing layer directions, hotend is pretty isolated from any plastic bits, so thats also neat

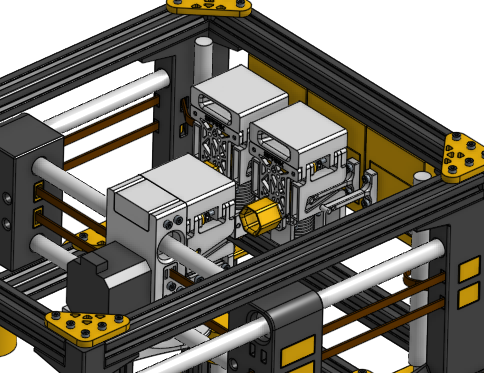
[picture p62: updatelogs/images/202603/03312026 - 4.png]
woo


added to the full assembly!

ALSO, note that theres not 14mm screw in onshape for M3 for some reason, so 16mm are used in CAD instead

i may have done a big silly and forgot that the belts run through that area. oops.

fixing some alignment stuff and the receiving latchs needing to be invert (since its not perfectly aligned with the screw hole, expected behavior), ok stuff aligned now!

so all left for cad is z axis, fixing the belt collision, and adding electronics (probably could do 2 and 3 after submission, so z axis priority)

was gonna say the linear rods would also hit the stepper motor conneciton, but we're fine since they're at different z heights, so they actually wouldnt (if they did, that wouldve been a real scare lol)

anyways, 7:08 PM now, off to dinner, quick commit!

ok, 8:30 PM and back! so, what's left? (yes, we changing the schedule a bit)

- 8:30 PM - 9:15 PM: z axis FINISH (aka, source all parts and cad them)
- 9:15 PM - 9:30 PM: Overall CAD check for any impossible actions or major issues
- 9:30 PM - 10:15 PM: Wiring check and making sure we are rated properly (and create wiring diagram)
- 10:15 PM - 10:30 PM: Firmware review (klipper) and check that everything is compatible
- 10:30 PM - 11:15 PM: Finish BOM (reduce BOM, use deals/remove some parts if needed)
- 11:15 PM - 11:45 PM: Add some logs back, clean up repository, tidy stuff up 
- 11:45 PM - 11:50 PM: Ship!

ok, z axis finish time

by sticking a ruler to my screen, it seems like the leveling screws go at least 20mm or 2cm, gonna assume 3cm for now?

gonna take some notes from 3/13/2026

- a build plate
    - voron 0.2 list says that any mic6 plate (1/4in or 6mm) is good enough
- silicone heater
    - heh (as in, uh oh)
    - CHECK WATTAGE
- thermistor, heater wires, and fuse (should include this in BOM)
    - we dont have thermistors left over (since i think its 1:1 with the extruder setup since it comes with it)
    - heater wires should be included in the silicone heater. i hope. please?
    - fuse is uh

so all we need is a silicone heater and electronics, metal block can be later

https://www.aliexpress.us/item/3256806676777974.html

yoink from voron, some silicon heaters from [keenovo](https://keenovo.store/collections/standard-keenovo-silicone-heaters/products/keenovo-square-silicone-heater-3d-printer-build-plate-heatbed-heating-pad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), originally was gonna use the 120mm x 120mm 120W 24 V one, but gonna change to the 100mm x 100mm 60W 24V one for power concerns (free shipping w)

crazy lag

so we currently have an issue where the z axis cant actually reach the tool head, BUT this is very fixable, its just an offset with the 3d print. do i do this now? idk. also, good news, keenovo gives a free NTC 100k thermistor! not sure if its usable though

ok, seems good, z axis seems good now! moving to cad check, i have an idea for the belt collision fix, gonna take a bit though, i think its wiring time

oh wow thats a perfect fit, not a good idea

good news! the electronics do in fact fit, probably gonna get a giant panel somewhere to ziptie everything to, or just print something?

ok, electronics and panel cadded, checking for collisions, most of them arent very significant/easily fixed, fixed motor hole for tool not being big enough, only significant one really is the belt, but ill do that tomorrow i think

ok, wiring diagram time! quick commit...

- 9:30 PM - 10:15 PM: Wiring check and making sure we are rated properly (and create wiring diagram)
- 10:15 PM - 10:30 PM: Firmware review (klipper) and check that everything is compatible
- 10:30 PM - 11:15 PM: Finish BOM (reduce BOM, use deals/remove some parts if needed)
- 11:15 PM - 11:45 PM: Add some logs back, clean up repository, tidy stuff up 
- 11:45 PM - 11:50 PM: Ship!

MAGNETS MAGNETS MAGNETS

so aliexpress through the worst timing curveball of all time. remember those 5 motors? yeah, the price increased $21, and they dont ship here anymore.

ok, found one also from stepperonline, just requires using the aliexpress deals though, since its otherwise crazy expensive, old link is an alternative now

ok, did a bunch writing on the readme, its 10:47 PM right now

went to use the bathroom for a bit, i think its just BOM, electrical diagrams, and thats it!

ok, bom updated, moving to csv, time is 11:28 PM

11:42 PM, bom done, gonna work on submitting now, electrical digram will come in a sec, step uploaded, quick commit!

ok, shipped! its 12:31 AM, i need to start working on hw, but here's the deal:

- electronics diagram
- update journals

i could do those tomorrow, given spring break starts the day after! (well, tomorrow is today, and the day after is tomorrow, but you get the point)

ok, for now, good night!
