HenryLi-0/spark/updatelogs/logs202603/03292026.md

# 3/29/2026 - 46th Update!

welcome back! it's 10:00 AM, and its the final days of blueprint! (as of now, 1 day and 14 hours left)

so, yesterday i finished three courses for BWSI in one afternoon and evening! (i spent the morning writing a new timelapse script, along with loading ubuntu on a usb!) so, now, what's today? today's everything left. cant believe im saying that, but today and tomorrow are theoretically the last days here, at least for design

so, let's slice up the day! i've allocated some 11 hours today!

todo (yes, same thing but without any dates now, those are hours!):

(yes im editing this again and again, looked through the commits to see how the plan below has changed!)

(well i guess i just stopped editing this since it was too far up...)

- 10:00 AM - 10:15 AM - Setup
    - Setup and scheduling
- 10:15 AM - 11:30 AM - Z Axis
    - Finish bearing/rotational areas of the Z axis
    - Fix any conflicts
    - Place into assembly
- 11:45 AM - 12:20 PM - helping a friend
- 12:20 PM - 1:00 PM - Continue Tool Area and Docking
    - Alignment (tool base to tool) system work
    - Start work on docking (tool to dock) system work 
    - Test printed docking latch mechanisms? (probably not, this can be fixed later)
- lunch and somehow sleep now somewhere here
- 4:20 PM - 6:00 PM - Finish Up Tool Area
    - Finish the tool (extruder)
    - CFD on the part cooling if time allows, otherwise can do later
    - Check for collision
    - Gearing, fake bearing featurescript?
- 7:30 PM - 8:30 PM - Work on Docking Bay and Check Collisions
    - Do most of docking bay (realistically, not much)
    - Overall CAD Full Assembly (shouldnt be hard at all)
    - Overall CAD check for any impossible actions or major issues
- 8:30 PM - 9:30 PM - Electronics and Firmware
    - Wiring check and making sure we are rated properly
    - Firmware review (klipper) and check that everything is compatible
    - Work on BOM if done early
- dinner somewhere here
- 9:30 PM - 11:00 PM BOM and Ship
    - Add some logs back
    - Finish adding everything to the BOM
    - Reduce BOM, remove some parts if needed
    - Final check and ship, shouldnt be pushed to tomorrow (essay writing and stuff)

well, thats kinda unrealistic to an extent, but i think yesterday was a good warm up for today! anyways, BOM and ship time kinda has to be today. well, lets get setup!

gona have to do some weird designing here, we dont have motor mounts for the z axis oops

ok, shifted a bunch a time by half an hour, i really need to get the mindset to do it and fix later for now

so we do need longer screws/decrease the distance, since onshape doesnt have 30mm+ for M3 screws (and we cant use M4, since the motors use M3)

or you know, just move the whole thing up.

well, there we go! bit of moving, but there it is!

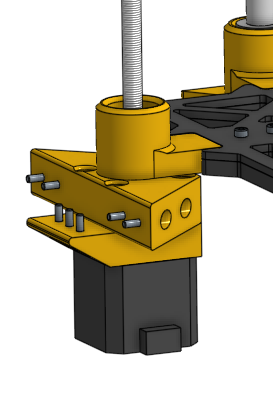
[picture p63: updatelogs/images/202603/03292026 - 1.png]


section view if anyones curious

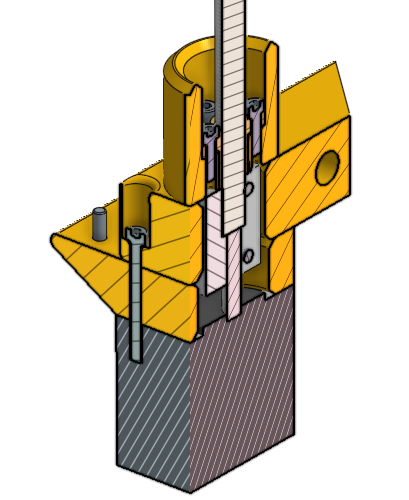
[picture p64: updatelogs/images/202603/03292026 - 2.png]


i really need to stop squinting...

well, commit for now, gonna move on, though we dont have a build plate just yet

ok, adding it to assembly, it seems that the z motor mount bottom screw thingy clips into the stands

11:40 AM, quick break

ok, wrote some email sending script for a friend, gonna change the schedule a bit...

ok, we're back at 12:20 PM! time to get back to working on the tool... oh right, shift that thing

oh i forgot to press record on the timelapse thing just now, oops

this cad... it scares me sometimes

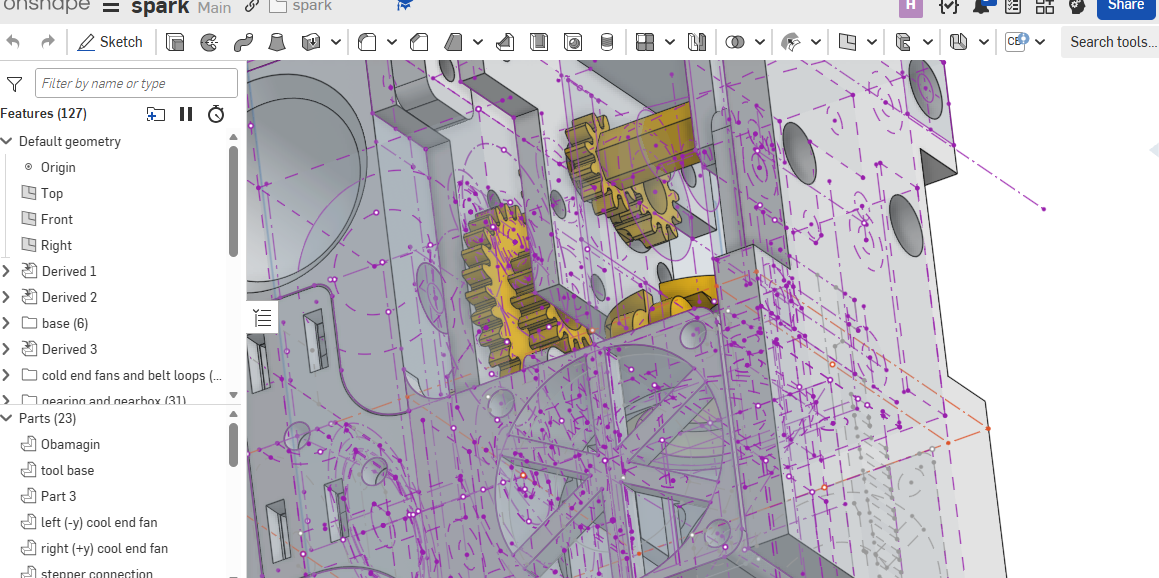
[picture p65: updatelogs/images/202603/03292026 - 3.png]
aaa


like, that is terrifying. now, time to figure out whats left? ok, seems to be:
- air area (as in the part cooling fan)
- random spacers and bearings (feature script it!)
- get the top alignment thing to be screwed on somehow instead of being in one giant piece (fairly straight forward)
- latches (for docking)
- meshing area (as in, part that grabs the filament)

ok, so for strength of parts, the layer lines of the tool base will be along the y axis (youll need to open up the cad for this), and im thinking we just have two screws that anchor the top bit down, it would be really wasteful to have a bunch of supports to keep the two ends on (but imo thats the best option here), but it wouldnt be as strong to keep two things on the side?

why not both

just kidding i dont think we can fit any more screws into the BOM (thinking of just relying on the welcome deal again for the stepper motors (whys it always the motors?))

gonna cad a fake bearing real quick and see if i can get it printed, 0.7cm OD, 0.3cm ID, 0.3cm width/height

we need some 1.5cm screws

ok, sent off to the printer with a 0.08mm profile!

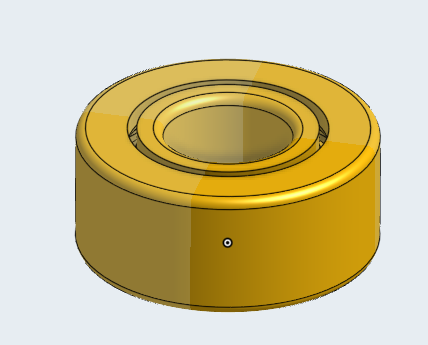
[picture p66: updatelogs/images/202603/03292026 - 4.png]


ok, so while thats working, time to work on the screw thingy for the top, ill probably just use two of the screws from earlier for this, or some of the 15mm ones? idk, can change this later

seems like they only come in batches of 40pc. huh. anyways, for the bearing, my guess is that the prints gonna fuse with itself, id be impressed if it doesnt? anyways, idk how to incorporate 40 30mm screws in this build

oh its done printing! as expected, it spaghettied. ok, 1:08 PM, off to lunch!

unshockingly, im incredibly tired after yesterday. yes, i just fell asleep and napped for like 2 hours, so its 4:18 PM now. anyways, the bearing printed with rafts and then seems good, as in, it looks like it wouldve worked, but removing rafts is PAINFUL (and pretty much impossible), so i can't tell if that was good. maybe we add like a giant flange or something to stop if from falling off the printing plate? anyways, a splash of water to wake up and we're back.

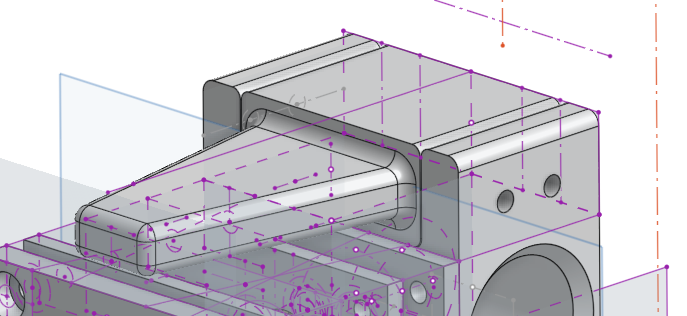
[picture p67: updatelogs/images/202603/03292026 - 5.png]


- air area (as in the part cooling fan)
- random spacers and bearings (feature script it!)
- latches (for docking)
- meshing area (as in, part that grabs the filament)

i snacked on an entire peanut bar already

trying to figure out how this gearing worked again

ok so the -y side uses a live axle, the +y side use a dead axle. how nice. anyways, how does the gripping thing look like? idk

oh someones finally using the cad im referencing and seems like the changed some stuff. huh.

well i have no clue how to cad that, so latches or air area for now, aim to finish by 6:00 PM, then assemble that, then speedrun loading bay

huh so its called a push push latch?

i think onshapes having a bit of a funny right now, somehow the latch sketch is not updating? ok force an update through an extrude

ive confused myself

ive really confused myself, changed it to be one path, then realized it doesnt make sense (breaks the return)

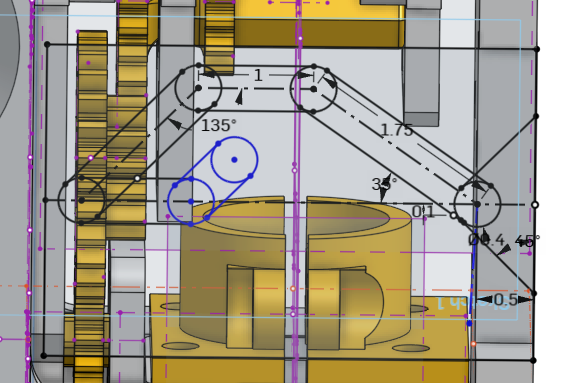
[picture p68: updatelogs/images/202603/03292026 - 6.png]


brb, gonna get water and think about it

am i imagining this? did i never draw the updated mechanism or at least take a picture? i guess not

just gonna restart at this point

dont think its a push push latch...

wait im definitely overthinking this, this can be solved with two corridors, a bar, and a rubber band

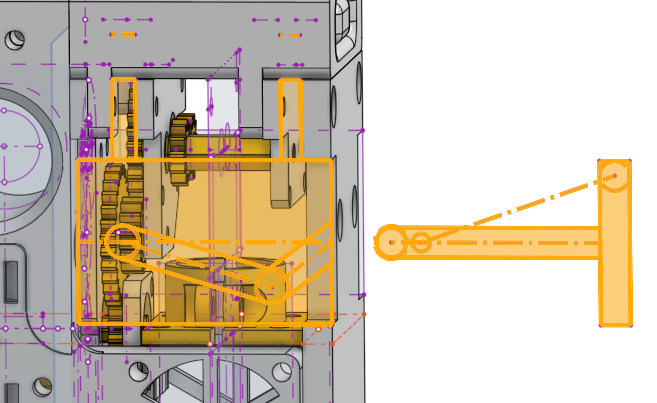
[picture p69: updatelogs/images/202603/03292026 - 7.png]


so the idea is the protruding/extended side goes in, and gets pushed down, rubber band pulls the position up, along with supporting the weight of the tool, then it goes back up and is "locked" because the tool wants to slide towards the extended side and that's being held by the rubber band.

oh wait that doesnt lock it in place to stop it from coming out enough

spoiler: this doesnt seem to be the solution, but tbh, this is just a 3d printed part, theres WAY more important stuff we need to design first

part cooling stuff for now, quick commit!

i have absolutely no idea how im gonna try cadding this curved surface, like if you view it from the side, you can see the top down and what not, but that's also not exactly where it is (nor does it inclue much info about the insides)

ok, so i poked around the onshape ui and my memory a bit, and yes, theres a shell feature! now to design with top down side...

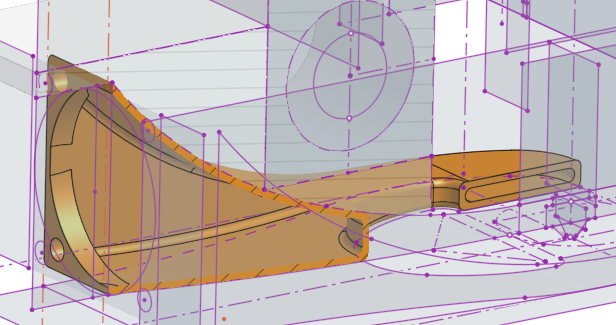
[picture p70: updatelogs/images/202603/03292026 - 8.png]


well that was pretty fast... just did some negatives and removing and stuff and shell and i guess that worked well! wow, easier than i thought (at the time of writing, i commited 24 mintues ago) obviously, this part is pretty much impossible to print with supports (as in, it'll be really difficult to remove supports inside), but it might print fine without? idk, top might slope (bottoms also curved, we actually do need some supports, maybe just on the outside? idk)

well, its 7:18 PM now, off to dinner! so when we come back, just cleaning up, add some screws for more mounting, and then some spacers/bearings, just whatever for the latch, then we can get assembling!

10:06 PM, meaning 1 day and 2 hours until its time. ok, lets clean up the tool, fast though! (i still have homework aaa)

ok, cleaned up the sides (they didnt really serve a purpose), time to move the rollback bar down! oh speedrun latch time i guess

wait i just remembered the issue of the filament tube sorta needing a place to go

ngl its probably best for me to just go with it for now, then fix it later, since those are all 3d printed and can be changed afterwards

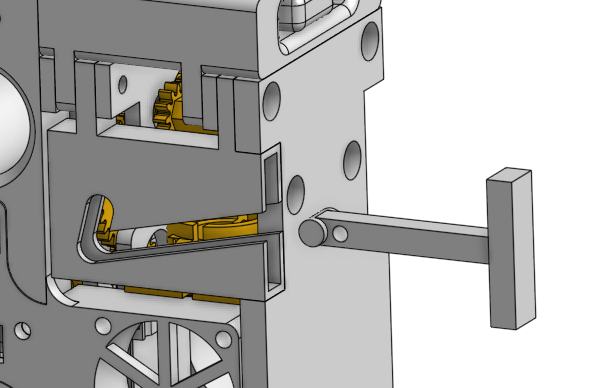
[picture p71: updatelogs/images/202603/03292026 - 9.png]


it would be really funny if this works (it wont, 0.5cm is also a bit on the high side in terms of flexibility, imma turn that down)

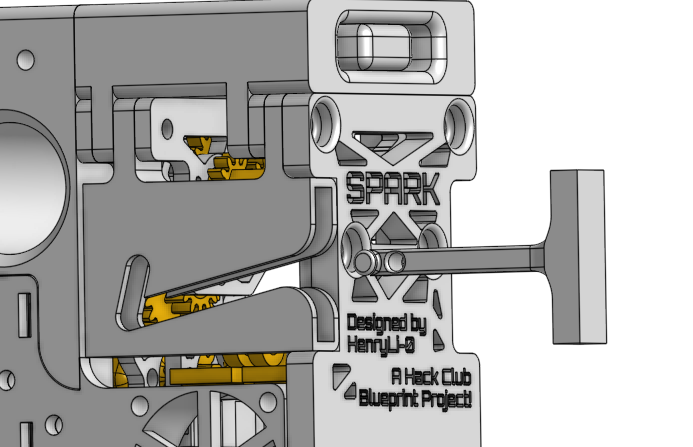
[picture p72: updatelogs/images/202603/03292026 - 10.png]


10 pictures in one day? thats a new best for here! (i think?) the latch bit sorta looks like a certain shoe company's logo for some reason...

anyways, assembly time! (10.49s regen time for part studio aaa)

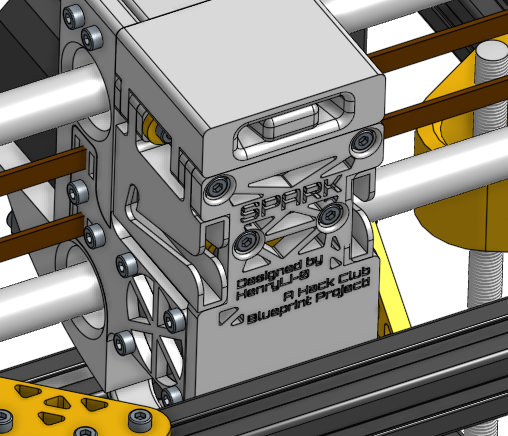
[picture p73: updatelogs/images/202603/03292026 - 11.png]
woo


woo! some parts are missing (the axles for the gearing, adding the bearings, etc.), but nothing major (aka, everything missing can be 3d printed), so thats it for the tool head for now?

so we still have

- z axis print bed
- docking area
- electronics and firmware

might have to do this tomorrow, its 11:30 PM...

ok, quick homework break for now! here's a commit!

yo, not back, but theres no way the internet went down the second i try to speedrun homework

anyways, back at 3:14 AM, obviously not for long (internet was repeatingly breaking, then broke the Pacific Arc DP1005's tip so badly while trying to fix it im pretty sure its not fixable any more, then got sad and did homework slowly), but we might have a bit of an obvious oversight

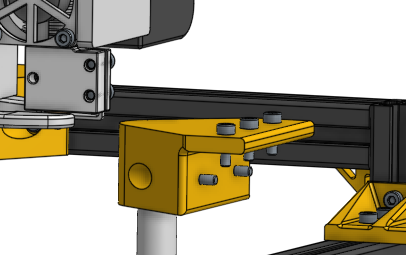
[picture p74: updatelogs/images/202603/03292026 - 12.png]
uhh


well, might have to miss another robotics meeting, theres A LOT still left to do for both things... 

oh yeah, the issues are that the extruder would hit that, and the bigger issue that there's no structure there (solution might just be raising the top part)

ok, that's it for now, good night!
