HenryLi-0/spark/updatelogs/logs202603/03302026.md

# 3/30/2026 - 47th Update!

well

ok, so its 2:30 AM on 3/31/2026, sorta got caught up in BWSI essays today, but good news! blueprint's deadline has been pushed back a day, so this means that todays the actual final day. anyways, imma just prep the todo list for tomorrow (well, today)

- Fix collision issues
- Work on Docking Bay and Check Collisions
- Overall CAD Full Assembly (clean up)
- Overall CAD check for any impossible actions or major issues
- Wiring check and making sure we are rated properly
- Firmware review (klipper) and check that everything is compatible
- Finish BOM (reduce BOM, use deals/remove some parts if needed)
- Add some logs back
- Ship!

well, imma just fix the collision issues right now

side heights update! frame size is no longer linked to print area (as in, you can move the extruder up without the entire frame changing)

a couple major changes, gonna be removing the middle extrusion thats just lowered and switch it to just be at the same height

did you know? a large amount of the cad is based on a single point in the side heights

ok frame updated, im expecting coreXY not to like this very much?

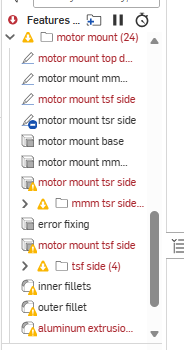
[picture p75: updatelogs/images/202603/03302026 - 1.png]
uhh


yeah

i think im just gonna redesign the whole thing

should probably add the couplers for here too, nvm cant do that, thats for the t8 screw. did some playing around with `raven`'s motor, it seems that plastic is ok, just that it does slip at some point (lower speeds are fine), thisll probably be an issue somewhere down the line, not gonna do BOM stuff right now

anyways, here we go!

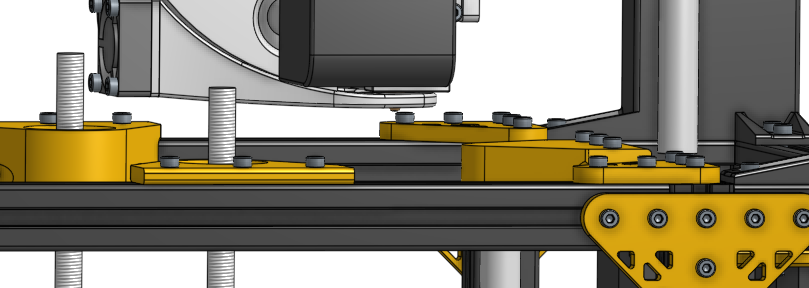
[picture p76: updatelogs/images/202603/03302026 - 2.png]
waw


wait the screws clip in to the frame a bit, could probably just shift that a bit. well, it's 3:22 AM, good night!
