HenryLi-0/spark/updatelogs/logs202603/03242026.md

# 3/24/2026 - 45th Update!

woo, ignoring that rift in time, we're back! why am i so tired? well, just wrote three essays for a scholarship application of sorts, kinda tiring. anyways, its 1:43 AM now, realistically only wanna do this until 2:00 AM, then spend the rest of the night reviewing for a math exam tomorrow (ive fallen off havent i?), so yeah! no time to waste!

today's supposed to be the last day for z axis, here's the dealo. basically, we just need the spring screws (ouch BOM) with the heater (ouch BOM) and the plate (ouch BOM) on top. hmm. given by the fly that just came out of the BOM spreadsheet, we're kiiiiiiinnnddaaaaa stretch thin. (welp $30 buffer time?)

completely ignoring that, let's continue!

why the internet slow

added LM12UU bearings to the coreXY assembly

oh yeah ive recently been busy trying to make a perfect jig to repair the tip of the Pacific Arc DP1005 mechanical drawing pencil, kinda sad the tips slightly bent so lead keeps snapping...

anyways, cant seem to find all the searching for the spring screw things...

[this](https://www.aliexpress.us/item/3256806676777974.html) seems good, $2.76 for a set of 4, i guess ill do that tomorrow, its 2:15 AM now, gotta go study for math!

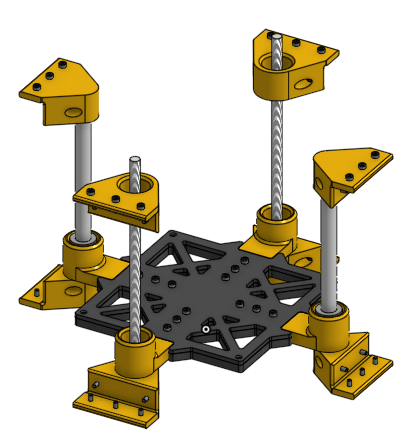
[picture p77: updatelogs/images/202603/03242026 - 1.png]
hmm


changes were the bearing area lifted thing for the bottom, which involved moving the side heights a bit, next thing is cadding the stand thing and then heater and we should be good there to move back to the extruder? ok, good night!
