HenryLi-0/spark/updatelogs/logs202603/03142026.md

# 3/14/2026 - 43rd Update!

today's pi day, and no, there is no pie. instead, whats so cool about pi? well, its simply traces all back to a circle. and you know what has circles? onshape! and you know what's on onshape?

welcome back! its 11:36 PM in NYC, and todays been quite a day! robot and stuff, us programming have to speedrun our experimental code and stuff in 4 days since construction decided to be 4 weeks behind. yeah. at least all our code is mostly written at this point, its just tuning and stuff! anyways, its actually bom time

so we need 24 F623-2RS bearings. yeah thats kinda pricy. after doing a bit of research, it might be viable to just not have flanges on the bearings (so a 623-2RS bearing) and no double sided rubber thing (since itll have the printed flanges anyways, more like a disc) (so a 623 bearing)? (oh i guess they dont make bearings without a rubber gasket thing)

you know like the tom holland looking at phone meme

anyways, after some searching and watching scarily high prices decrease, landed on
- [10pcs * 3 = $21](https://www.aliexpress.us/item/3256806875319927.html)
- [10pcs (3x10x4 mm) * 3 = $11](https://www.aliexpress.us/item/3256807482131308.html)

like ok ok, i see you, wow, these such crazy differences in prices sometimes... anyways, though it doesnt say the exact dimensions (as in, saying its a 623 or anything), it doesnt really matter since you can just change the inner diameter if anything (though, theyre probably the same). no clue what they're doing to get such low prices, but please keep doing whatever youre doing!

time to find screws, and i know just the place! thanks to past part sourcing, `raven` had some very cheap screws [here](https://www.aliexpress.us/item/3256804341271555.html)! 40pc of M3 10mm screws are only $1.61, which is great! i estimate probably 200 max for screw count? hopefully?

looking for the t nuts

- [100 for $6.05](https://www.aliexpress.us/item/3256807638725964.html)
- [200 for $11.81](https://www.aliexpress.us/item/3256807698416610.html)
    - ngl this one looks a bit sketch, whys one of the comment pictures used in the slides, might use the other one for $0.29 more

ok, updated more BOM stuff, i should probably actually get an accurate count of the number of screws we need, quick update to the bearing stacks though

M3 10mm screws
- 128 on the frame gussets only
- 48 on the stands and upper corners
- (so, 176 in the frame alone)
- 24 for the coreXY motor mounts
- 8 for the x sliders
- (so, 32 in coreXY, 208 in total so far)

so 240 screws should be good enough? i feel like the frame gussets might be a bit excessive?

well, thats mostly it for tonight!

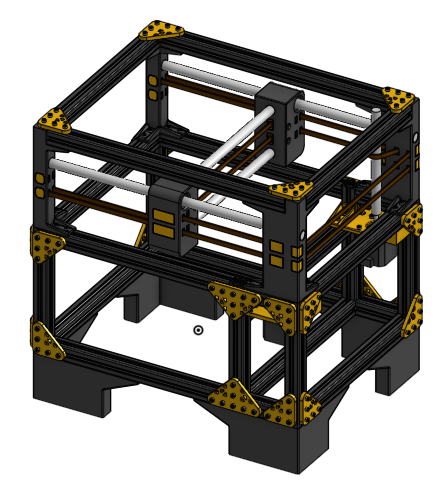
[picture p79: updatelogs/images/202603/03142026 - 1.png]
waw


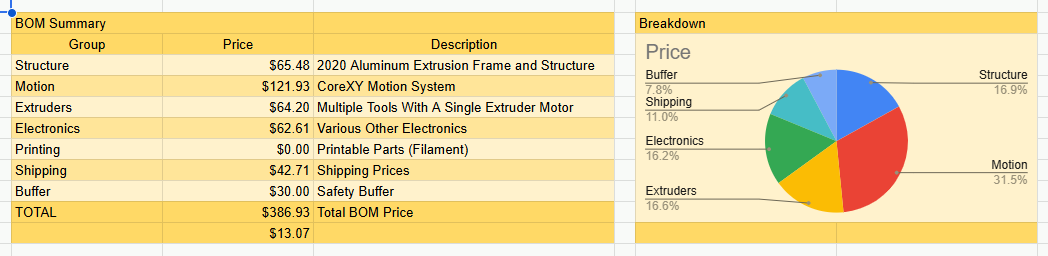
[picture p80: updatelogs/images/202603/03142026 - 2.png]
hmm


ok, 1:03 AM now, being forced to go to sleep, so thats with all the screws in and thats what the BOM summary currently looks like, probably gonna do another round of optimizing, then actually calcualting without the buffer? (well, we still gotta finish the cad)

anyways, that's it for today, good night!
