HenryLi-0/spark/updatelogs/logs202603/03132026.md

# 3/13/2026 - 42nd Update!

so uh yeah. this week was not fun. nor was last week. they need to give another break sometime soon...

anyways, we're back on this friday evening! its currently 10:29 PM, just had some hiccups involving some popup of sign in or something, but we're back! goal todaY? finish the z axis (overscope? too ambitious? idk)

todo:
- figure out the exact setup for a heatbed
- get 15x15cm, side heights, etc.
- find spring screw heatbed thingy
    - add such parts
- test min max height
    - and adjust
- limit switch location (and get limit switches/buttons)

oops got distracted in adding more led patterns to the macropad, hows it 10:57 PM already? also, ate a cherry today, i dont think i can eat cherries (because a small part of my lip kinda swelled a bit, not really significantly much, just a bit numb there, itll probably be fine)

quickly taking a page (literally) from the [voron 0](https://vorondesign.com/voron0.2) assembly manual, it appears that we need (in order from top to bottom):

- an optional magnet sheet
- a build plate
- silicone heater
- thermistor, heater wires, and fuse (should include this in BOM)

and of course, the spring screws of sorts keeps the whole thing up (also, these are pages 147-151 of the manual, v0.2r1)

whats the heat conductivity of metal

*glup* yeah these silicone things are EXPENSIVE (~$30)

did meanwell change their website or something, thinking of changing the `LRS 200-24` ($24.50) to `LRS 150-24` ($18.40), at the cost of turning the rated power from 211.2W to 156W. also, yes, this has become electronics day, reading over the voron guide stuff

stepper drivers

some old links since i need to close some tabs

- [couplers for t8 lead screws](https://www.aliexpress.us/item/2255799990666860.html)
- [lots of nuts](https://www.aliexpress.us/item/3256807638725964.html)
- [the 5 motors](https://www.aliexpress.us/item/3256802068491329.html)

ok, BOM updates, LOTS of work! removed lots of the old z axis stuff, starting added more "bigger" electronics

is it a big issue that some of the belt teeth will be in the direction of the bearing stacks

ok, had some fun and made a banner image! its a bit ambitious and bold for the state the projects currently in (well, almost almost done, sure, but still), but tried making it look cool! (its a bit too ad-like for my liking, might change it to just be an image and a list of features?)

time to address the fairly expensive elephant in the room, that being the heating stuff

- an optional magnet sheet
    - well, its optional right
    - i guess we dont need a glass plate?
- a build plate
    - voron 0.2 list says that any mic6 plate (1/4in or 6mm) is good enough
- silicone heater
    - heh (as in, uh oh)
    - CHECK WATTAGE
- thermistor, heater wires, and fuse (should include this in BOM)
    - we dont have thermistors left over (since i think its 1:1 with the extruder setup since it comes with it)
    - heater wires should be included in the silicone heater. i hope. please?
    - fuse is uh

also, [limit switches](https://www.aliexpress.us/item/3256805410237576.html), wow, digikey is way more expensive ($1.79 for [this](https://www.digikey.com/en/products/detail/omron-electronics-inc-emc-div/D2F-5L/Z8846-ND/8593137) on digikey, aliexpress is $1.66 or $1.80 for 10, with pulleys!) will need to check wiring though

stepper drivers stepper drivers stepper drivers

dr d flo back again with more docs! you know, this guys docs have come really helpful through this! anyways, [this](https://www.drdflo.com/pages/Guides/How-to-Build-a-3D-Printer/Stepper-Driver.html) article suggests that, with our motors being 1.8 deg steps, a cheap A4988 should be ok? now, is it compatible with a skr 1.4 turbo...

after much searching, it seems compatible! with some configs of course, [this](https://www.youtube.com/watch?v=u6pGsE7BZgg) video seems to explain it well! oh yeah, [heres](https://www.aliexpress.us/item/3256808903461933.html) the aliexpress link

ok, stepper drivers added, i guess today turned into a bom day?

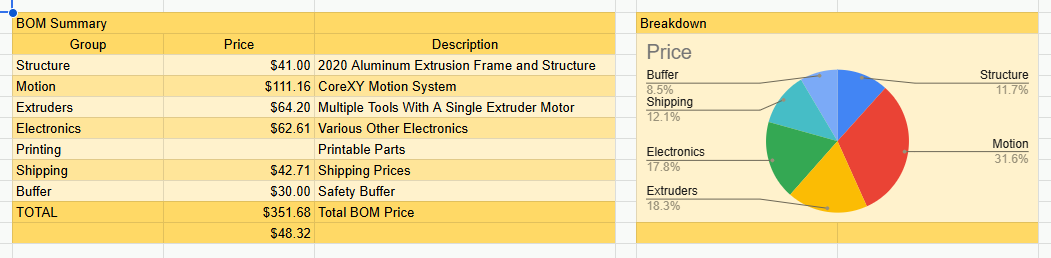
[picture p81: updatelogs/images/202603/03132026 - 1.png]
hmm


so, thats roughly $50 for all the heatbed stuff, some pulleys, wires, and all around screws? i feel like im missing something... but if im not, then that should be decent pace? like $35 for the heatbed, pulleys are strangely expensive for some reason, hopefully less than $10, for wires i could try to look if i could find any, screws probably $20 max? idk, thats still a bit over, but we still need to calculate the real numbers without the safety cap right now

ok, well, that's it for today! pretty nice and productive i'd say, hopefully can continue this? 17 days left... ok, 1:30 AM now, good night!
