HenryLi-0/spark/updatelogs/logs202603/03072026.md

# 3/7/2026 - 41st Update!

ok. you know like when a show's management decides to stop writing the story and to just keep dragging out the story forever? yeah, this project's been going on for too long, no way 146 days passed since the first log (thats 4 months, 3 weeks, 2 days). i think its about time we finish this.

9:50 PM, and this month has been absolutely miserable! ive decided to lay back on geometry dash a bit so that i can commit that time to this, hopefully i stick with it. now, time to write some logs... 

its 10:45 PM, that was a lot of writing (1/26/2026, 2/3/2026, 2/4/2026, 2/15/2026, 2/16/2026, 2/17/2026, 2/22/2026, that's 7 logs!)

waw

well, wrote 33x the limit...

ok, this is the last extension, 3/31/2026 is the FINAL day. no more. this ends here!

that means, around the time im writing this, theres basically 23 days left. aka, in this month of march, which has already proven to not be a calm march but more of a slow trudge through a paradox of fast and slow paced time warps, i gotta commit to this at the same time. no more extensions, no more excuses, i cant run from this any longer. it is time to finish this, its been going on for far too long lol

ok, now that ive hyped myself up, what now? well, build that z axis assembly! write that feature script or whatever for bearings! go go go!

new coupler since 2pc version of the other one isnt in stock right now?

i cant find anything saying the distance of the screws from the edge...

coupler

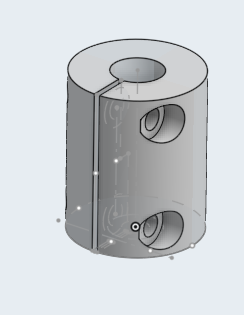
[picture p82: updatelogs/images/202603/03072026 - 2.png]


pulled measurements from various places, aliexpress doesnt have it themselves (the user manual links to some filament storage bag pdf thing)

ok after a bit more searching i think this coupler is ok, that shouldnt have taken so long...

so i did a bit of something and i think i lagged out a lot of the cad. uh.

not sure how i did this but looks cool!

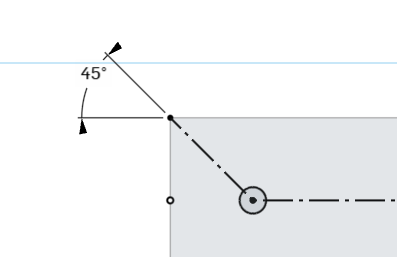
[picture p83: updatelogs/images/202603/03072026 - 3.png]


huh somehow did it again

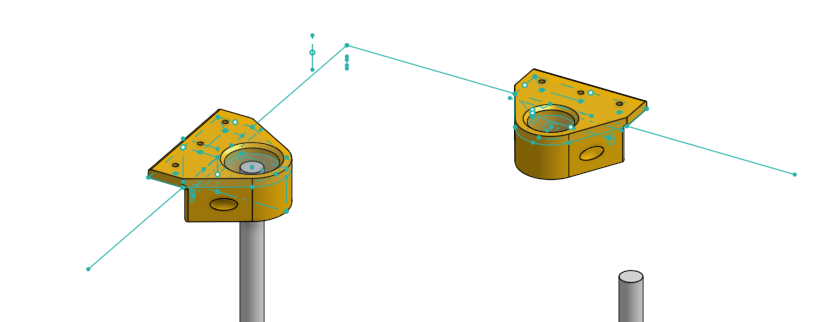
[picture p84: updatelogs/images/202603/03072026 - 4.png]


relatively slow day, but the bearing stands are there (idk what to call them)! 5 screws each, 3 on top, 2 on the sides, yes those two are different! ok, did some mirroring and theres 4 now!

ok, so this is pretty good now! next thing to do is the spring and heatbed setup, could probably get that done tomorrow if i finish my school homework fast enough... but yeah, that and then preparing for fake bearings later some time (featurescript somewhere) and then assemble it in assembly and that should basically be the z axis! (and some cable management considerations, of course)

its 1:30 AM now! gonna try to work on this tomorrow (hopefully? please?)! ok, good night!
