HenryLi-0/spark/updatelogs/logs202510/10272025.md

# 10/27/2025 - 5th Update!

yes, its actually 12:38 AM on 10/28/2025, i really should start doing this earlier... anyways, back to onshape!

so uh, this is pretty hard to cad, as i have no idea what measurements to put. anyways.

aaaAAAAahhhHh

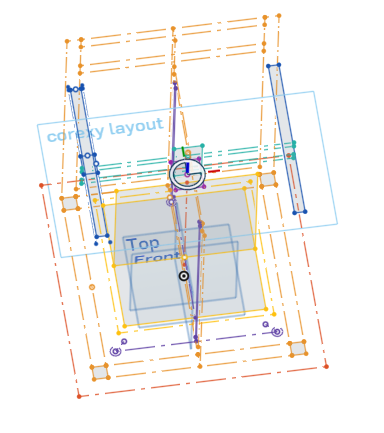
[picture p173: updatelogs/images/202510/10272025 - 1.png]
aaa


stuck with a worry that im going way too detailed, then concerned that im not detailed enough, since this is supposed to be a mastersketch after all. something something corexy belts up and down now...

increased outside length from 30cm to 34cm, should make more space for stuff inside?

ok, its 1:27 AM, brb! ok, back at 1:42 AM, im getting quite tired. given that i previously wrote PM (just fixed it to AM) probably shows this. anyways, here's the current state of things:

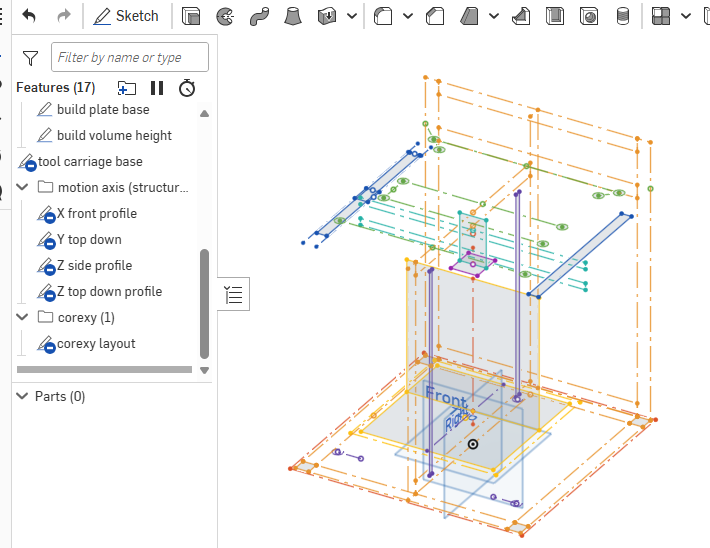
[picture p174: updatelogs/images/202510/10272025 - 2.png]
hmm


not too much done today, just added more motion axes, started adding corexy placement, and did the frame thing for the back, and turned stuff into construction lines. ok, good night!
