HenryLi-0/spark/(commit log)

2025-10-25 plans, rough BOM idea, more project scope stuff
2025-10-26 10252025 - plans, rough bom idea, and mroe project scope stuff!
2025-10-26 add limit switches oops
2025-10-27 10/26/2025 - start CAD stuff!
2025-10-28 10272025 - more cad stuff (mastersketch)
2025-11-05 11042025 - frame, gussets, and sourcing stuff!
2025-11-06 11052025 - work on mastersketch (coreyx and pulley locations)
2025-11-09 tool switching theory and z axis work
2025-11-10 11082025 - tool switching theory and z axis cad work
2025-11-10 11092025 - research and source some extruder stuff!
2025-11-16 tool work, hotend sourcing, finding and adding hotend part diagrams
2025-11-16 11152025 - lots of cad work (frame updates, belts, hotend) and sourcing!
2025-11-29 11282025 - more extruder work and placement changes
2025-11-30 11292025 - fixing -x printing space and start work on more frame parts
2025-12-08 12072025 - work on bom (mostly sourcing aluminum extrusions)
2025-12-20 -x -y and -x +y pulley area parts!
2025-12-21 12202025 - work on coreXY frame pulley area parts
2025-12-21 +x -y and +x +y pulley area parts!
2025-12-25 12242025 - start coreXY motion cad stuff!
2025-12-26 xy motor mounts, coreXY assembly, and bearing stacks!
2025-12-28 12272025 - start work on tool base and being tired
2025-12-30 12292025 - a bunch of tool work! (gearbox + cold end mount)
2026-01-02 01012026 - fan mounting, brackets, belt clip areas, and fixes!
2026-01-19 01182026 - working on z axis and BOM
2026-01-21 01202026 - start optimizing for bom
2026-01-26 01252026 - doing some BOM optimization updates!
2026-01-27 01262026 - start z axis work!
2026-02-04 02032026 - reflections and back to z axis work!
2026-02-16 02152026 - make tool part studio less laggy for now, start z axis cad
2026-02-17 02162026 - z axis lift work
2026-02-18 02172026 - more z axis work, then BOM work
2026-02-23 02222026 - switch to 5 motors and add stands
2026-03-08 03072026 - and z axis work continues!
2026-03-14 03132026 - a lot of bom work!
2026-03-15 03142026 - even more BOM work!
2026-03-23 more z axis work (bronx science edition)
2026-03-25 03232026 - more z axis work! (assembly too!)
2026-03-25 03242026 - (just a bit) more z axis work!
2026-03-29 z motor mount
2026-03-29 part cooling fan and tunnel!
2026-03-30 tool head assembly!
2026-03-30 03292026 - z axis work, tool assembly mostly done!
2026-03-31 03302026 - some frame fixes!
2026-04-01 finish z axis stuff!
2026-04-01 a lot of readme, BOM, and clean up work!
    [BOM.csv, config.cfg]
2026-04-05 wiring diagram!
2026-04-06 04052026 - wiring diagram stuffs!
2026-04-10 updated BOMs!
    [BOM.csv]
2026-04-10 04092026 - update all BOM prices!
2026-05-18 05162026 - updating bom data!
2026-05-19 05182026 - a search for linear rod replacement!
2026-05-24 quick bom fix, buying stuff now!
2026-05-25 05242026 - bom ordered!
2026-06-13 06122026 - test prints and start fixing some cad issues!
2026-06-20 06192026 - a bunch of cad fixing work!
2026-06-25 06242026 - printing all the frame gussets!
2026-06-26 06252026 - stands printing, extrusion and rod cutting, and start irl frame assembly!
2026-06-27 06262026 - lots of irl frame assembly (mostly complete!)!
2026-06-28 06272026 - irl assembly of frame stands, v6 extruders (all three!), and tool base (starting)!
2026-06-29 06282026 - some cad updates, motors mounted, and start of z axis irl assembly!
2026-06-30 06292026 - scheduling, z lift irl assembly, electronics work, and docking bay cad update!
    [config.cfg]
2026-07-01 06302026 - corexy layer irl assembly and electronics work!
    [config.cfg]
2026-07-02 07012026 - more electronics work, fixed t rods, and a build plate!
2026-07-03 07022026 - corexy belting and attempts at extruder prints
2026-07-04 07032026 - belting, tools, and even more electronics work!
2026-07-05 07042026 - lots of electronics work!!!
    [config.cfg]
2026-07-06 07052026 - limit switches mounted and more config work!
    [config.cfg]
2026-07-07 07062026 - other tools assembled!
2026-07-08 07072026 - corexy seems decently reliable now!
    [config.cfg]
2026-07-09 07082026 - latches, calibrations, and extruding!
    [config.cfg]
2026-07-10 07092026 - it's printing! (badly)
    [config.cfg]
2026-07-11 07102026 - test prints and tuning! (printing a bit better!)
    [config.cfg]
2026-07-12 07112026 - more test prints, video editing, and shipping!
2026-07-24 changes from open sauce!
    [config.cfg]
